AjayaDahal/TPMS-2018-Toyota-Yaris-iA/docs/premortem.md

# Premortem: how this TPMS panel could fail

**Date:** 2026-11-05, revised the same day.

**Scope:** everything, including the outline, which was accepted from the in-car paper fit on 2026-11-09.

## The setup

- **The car.** The Yaris iA's own TPMS is **indirect**: it compares ABS wheel speeds and has no sensors in the wheels. It keeps working on its own and never interacts with this panel.
- **The sensors.** You had four **GM/Schrader EG53MA4** sensors installed in the tyres, and this panel is their only receiver. Their protocol is known:
  - 315 MHz, OOK (on-off keying), Manchester coding, 123 µs half-bit;
  - a 120-bit message with ID, pressure, temperature and a checksum;
  - rtl_433 already decodes it as `Schrader-EG53MA4`.

> **Correction:** the first version of this premortem assumed factory Mazda sensors with an unknown protocol. That was wrong, and that risk doesn't exist.

The bring-up firmware now decodes these sensors directly. It lists each one's ID, pressure (kPa/psi), temperature and signal strength.
- The decoder follows rtl_433's slicer and frame checks.
- It's unit-tested with synthetic EG53MA4 transmissions: a valid frame, two repeats, a bad checksum and a truncated frame.
- It hasn't been tested against a real capture yet.

Imagine it's a year from now and the panel is sitting in a drawer. These are the most likely reasons, most likely first.

## Ranked failure stories

| # | How it fails | Likely? | Early warning | Mitigation | Status |
|---|---|---|---|---|---|
| 1 | OLED burn-in from a static screen | **High** (over months) | Ghost outlines | Firmware: dim or blank after ~30 s with no alarm, wake on knob or alarm, shift the layout a few pixels every few minutes | Firmware rule (below) |
| 2 | "It receives nothing" in the garage | **High** (early on) | Silence while parked | EG53MA4 sensors transmit when the wheel turns (about once a minute while driving) or when woken by the OEC-T5 tool. Parked, they stay quiet. Test by driving or with the tool | Documented; the bring-up firmware lists every sensor it hears |
| 3 | Readings from other cars, or the wrong wheel | Medium–High | Unknown IDs, values that jump, or swapped wheels after a tyre rotation | Learn the 4 IDs with the OEC-T5, one wheel at a time, and store them in NVS. Ignore all other IDs. Relearn after a rotation. Flag a wheel as stale if it hasn't been heard for 20 min while driving | Firmware rule; bring-up shows the IDs |
| 4 | Rear wheels drop out (weak signal) | Medium | Rear signal below about −95 dBm, or gaps | The E07 is tuned for 433 MHz (an estimated loss of up to ~10 dB). The FCC data still suggests 15–35 dB of margin. The radio now points its SMA down into the console pocket: use a 90° adapter with a 315 MHz antenna pointing straight back. If a rear wheel is weak, move the antenna out of the pocket on an extension cable, away from the steel floor tunnel. Check each wheel's signal strength with the bring-up firmware before the final install | Radio moved; measure |
| 5 | Board arrives and doesn't work, and it's unclear why | Medium | — | The self-test checks each part with a clear message. Power the bare board first and measure 5 V / 3V3 on the J4 pads before plugging in modules | Done |
| 6 | A module is plugged in rotated 180° (the CC1101's 2×4 header and the DevKit are symmetric) | Medium | Smoke | Before power, check the silkscreen: "1"/"SMA" on U1, "USB"/"ANTENNA" and pin names on A1, labels on J3 | Documented |
| 7 | Firmware never gets finished | Medium (lower now) | — | Reception and decoding are done in the bring-up firmware. Remaining work, in this order: learn mode → wheel layout UI → low-pressure alarm → burn-in protection → Wi-Fi/OTA (optional) | Plan |
| 8 | Vibration loosens the sockets | Medium | Random resets, blank display | Use machined round-pin gold sockets or solder the DevKit in. Add a dab of RTV on the modules. Put the antenna on an SMA extension. Crimp ferrules on the J1 wires | Documented |
| 9 | Heat in a parked car (70–90 °C) | Medium | Resets or a fading display in summer | The OLED, ESP32 and CC1101 are rated to 85 °C, so mount the panel out of direct sun. U4 has a copper heatsink pour. Avoid full-white screens (or use display jumper option #1 with JP1) | Pour done; mounting is your call |
| 10 | Random resets on the bench | Medium | Resets when the screen is bright or Wi-Fi is on | A laptop port (500 mA) can't supply the OLED's ~375 mA plus Wi-Fi peaks. Use a 12 V supply or a powered hub | Documented |
| 11 | One sensor goes quiet | Low–Medium (over years) | One wheel stops updating | Sensor battery life is typically 5–10 years, or a sensor may be in its off/storage mode. Show "stale" for that wheel and wake it with the OEC-T5 | Firmware rule |
| 12 | Garbled display or failed radio set-up from the shared SPI bus | Low | Random characters, a wrong CC1101 VERSION | The firmware uses 4 MHz SPI, transactions, and weaker SCK/MOSI drive for the ~100–130 mm tracks. The CC1101 releases MISO when it isn't selected | Done |
| 13 | Interrupt flood at boot from GDO0's 135 kHz default clock | Low | Watchdog resets | Configure the CC1101 before attaching the IO34 interrupt | Done in the firmware |
| 14 | Car battery drained | Low (if wired right) | Dead battery after a few days parked | ACC only, never constant 12 V. The panel draws ~1 W, which flattens a battery in about two weeks. Fuse the tap | Documented |
| 15 | AM radio buzz from the 5 V switcher | Low | Noise on AM | Add TRACO's EMC input filter to the 12 V lead | Documented |
| 16 | Front USB sockets don't charge or connect | Low | Phone doesn't charge from a front port | They are passive USB passthrough cables, not wired to the board (U3 can't power phones). One plugs into the car's USB port, the other into a 12 V USB charger in the 12 V socket | Plan set |
| 17 | A substitute part doesn't fit | Low | — | Avoid: R-78E (28 V max), a passive buzzer, blue/white LEDs on 220 Ω, a WROVER or 38-pin DevKit | Documented |
| 18 | Doesn't fit the console opening once built | Low–Medium | Board doesn't sit flush | The template matched the opening under the HVAC controls, and a caliper span agrees. The board is 1 mm smaller than the opening on the sides and bottom so it can't be too big. Gaps are closed by a 3D-printed bezel/chassis, which can also space the board forward if the 12 V/USB/AUX strip behind it is in the way | Outline accepted; chassis later |
| 19 | The shift knob (in P) hits a cable in the right USB socket | Medium | Cable touches the knob in P | Measure the gap; use a 90° USB cable, or move that socket up and left | Check |
| 20 | Losing the car's 12 V socket / USB / AUX behind the panel, or the plugs keep the panel from sitting flush | Medium | Panel stands off at the top | Two USB passthroughs bring the car's USB and a 12 V charger to the front. The car's ports face the panel, so use 90° USB-A adapters and a flush 12 V charger, and leave slack. The 8 mm side slot is free for an extra cable. The 3D-printed chassis can space the panel forward if needed | Plan set; check depth |
| 21 | The passthrough sockets don't fit the holes, or their nut hits a part | Low | Thread won't go through, or the nut doesn't sit flat | The thread was measured at 25.16 mm (M25 class), so the holes are Ø25.8 mm. The Ø38 mm parts-free circle on both sides fits a typical M25 nut (35–37 mm across corners); the nearest part (U3) is at 19.8 mm. DRC-enforced. Ease with a round file if a thread binds | Holes resized |
| 22 | USB cables add noise at 315 MHz | Low | Noise floor rises when a phone is connected/charging | Route the cables away from the antenna; clip-on ferrites near the plugs; compare the bring-up firmware's noise floor with and without a phone | Check at bring-up |

## Firmware rules that prevent several of these

- Configure the CC1101 before enabling the GDO0 interrupt. Never put the CC1101 in transmit mode.
- Only accept the 4 learned IDs. Store them in NVS when they change; ACC can cut power at any moment.
- Show "no data" or "stale" per wheel instead of an old value.
- Protect the OLED: dim or blank it when idle, and shift the layout periodically.
- Keep alarms audible (buzzer) and glanceable (wheel LEDs), so you don't need to read the screen while driving.

## Next steps, in order

1. **Optional quick check now:** run `rtl_433 -f 315M` on your RTL-SDR while driving. It should print `Schrader-EG53MA4` lines for all four tyres. Note their IDs, and wake each wheel with the OEC-T5 to see which ID belongs to which wheel.
2. Order the PCB (`tpms_panel_gerbers_jlcpcb.zip`). The USB holes already match the measured thread.
3. Assemble and run the bring-up firmware: self-test, then the sensor list with signal strength per wheel.
4. Build learn mode, the wheel layout, alarms and burn-in protection.
5. Install: fused ACC tap, antenna placement, vibration-proofing.
