AjayaDahal/TPMS-2018-Toyota-Yaris-iA/TPMS_project_report_ECE6723.pdf

# ECE 6723 Embedded System

# Spring 2022

# Grad Project - TPMS Monitoring System

# Student: Ajaya Dahal

# Department of Electrical and Computer Engineering Bagley College of Engineering Mississippi State University

# Date: May 10, 2022

## 1. Introduction

For a long time, I wanted to design a 315MHz receiver from scratch using analog components. The motivation came from my car. I have a car with tire pressure monitoring system sensors on all tires. However, the infotainment system is not as advanced that would tell me which tire is low on tire pressure and by how much. All it could do is turn on the tire pressure sign on the dashboard. After reading [5], I was able to find out about the TPMS sensors. In the United States, a 315MHz (https://tpms247.com/blogs/tpms-faq/73376901-tpms-frequencies-315-mhz-433mhz) transmitter
[6] is used by the TPMS sensors. The initial idea was to design a PCB that uses analog components that will be able to receive at 315MHz. But after looking into rf circuit design, it was easier to simply use a 315MHz receiver (https://www.amazon.com/HiLetgo-Transmitter-Receiver-Arduino-Raspberry/dp/B00LNADJS6) as shown in figure 1.1 to accomplish this.

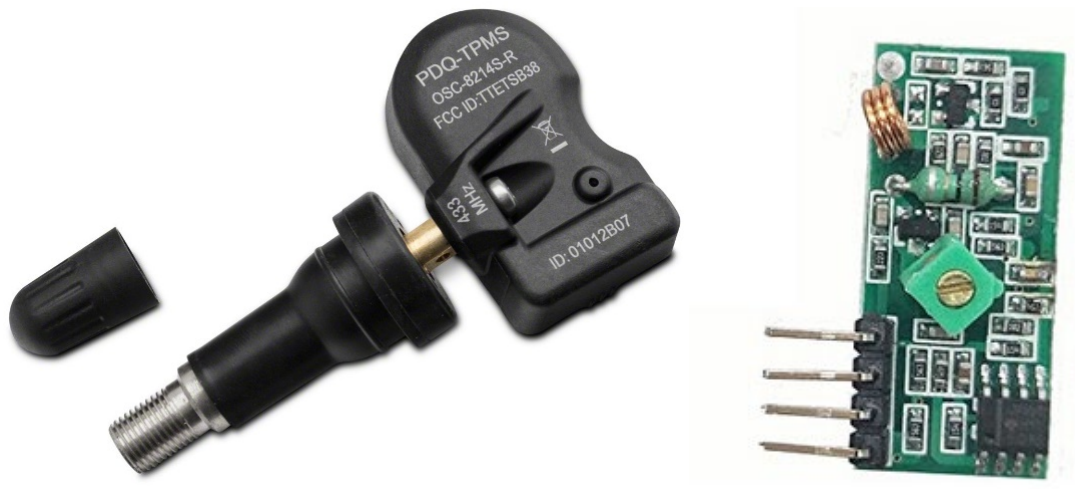
[picture p3: figure]

Figure 1.1: TPMS sensors on the left and 315MHz receiver on the right.

## 2. Literature review

There has been some similar work in this field. The engineer from [1] used the Seeduino Xiao microcontroller and TI CC1101 Module to create a device with a 1.8 in TFT SPI display. The engineer has done a lot of work and has a big contribution to the various model of cars. Similarly, the author from [2] was able to provide a huge insight into how this TPMS sensor works. Although this method is to create the TPMS sensor, it helped to understand the thought process while designing one of these sensors. Using the FCC ID of the sensors, I was able to retrieve the datasheet [3] of the device. Figure 2.1 is the screenshot from the datasheet showing

## the brief information about the sensor:

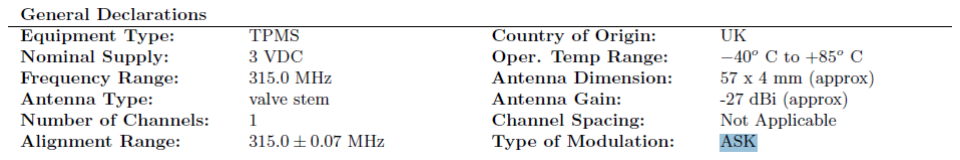
[picture p4: figure]

## Figure 2.1 General Overview of the Sensor

Reading the datasheet provided lots of technical details about the sensor. After reading the

## datasheet it was clear that the sensors transmit at center frequency 315 MHz with ASK modulation with the emission bandwidth of 0.0550MHz at 20 dB EBW max at 0.7875 MHz. The

sensor has 7 modes of operation.

## These modes are shown in table 2.1 below:

## Table 2.1: Different modes of operation of the sensor

Emergency Modes | Consumer Use Modes | Manufacturing & Service Modes | Mode of Operation | Explanation | Frequency of Transmission
| | X Forced | Transmission "Learn Mode" (dealer / plant) | On receipt of a particular LF sequence this Forced transmission allows the interrogation of the sensor in the vehicle factory or dealership | Forced Transmission as required
| | X | Low battery | Transmitter in normal operation when a low battery flag has been set - wheel is rotating | Transmission rate depending on Drive mode
| | X | Off Mode | Part is in an off state, No transmissions, Exit by LF orΔP | No transmissions
| X Stationary | | Mode
| X Wake Mode | | Fartory Drive Mode | First transmittion in normal operation - when wheel is rotating then moves into drive mode | At the start of wheel rotation
| X | | | Transmitter in normal operation - wheel is rotating | Transmission rate every 30secs
| X | | Drive Mode | Transmitter in normal operation - wheel is rotating | Transmission rate every 60secs
X Pressure Re- | | | Measure Mode | Transmitter in normal operation and meassuresment sample which is less then 5 counts than the pervious sample | Alarm transmission as required

As shown in the table above, the device has seven modes of operation.

## 3. Methods

The receiver is compatible with any microcontroller and the engineers who designed this has also built a library. Figure 3.1 shows the schematics of the receiver that can be considered in the future when designing a PCB with all components on a single board.

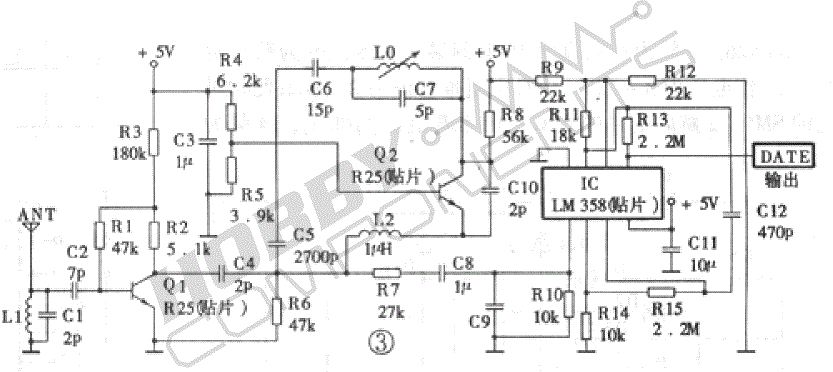
[picture p5: figure]

## Figure 3.1: Schematics of the MX-05 (HCMODU0007) receiver module. [8]

After learning about the receiver, sensor, and its different modes of operation, the project then moved to learn about ASK modulation.
As per the source [4], “With Manchester encoding, bit transitions near the mid-point of bit periods determine the polarity of the transmitted and/or received bit. A rising transition/edge in the middle of a bit period typically corresponds to a logic “0” while a falling transition during the middle of a bit period corresponds to logic “1” as shown in the demodulated waveform timing diagram of Figure [3.]1. Transitions at or near bit boundaries are ignored”.

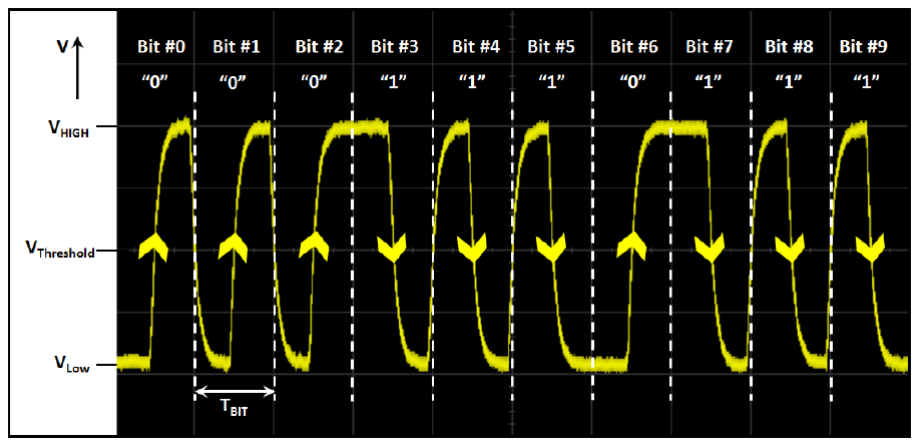
[picture p6: figure]

Figure 3.2: Bit polarities based on Manchester encoding.

## Further reading PowerPoint from LinkedIn [7] helped to understand ASK modulation and

demodulation, Figure 3.3 shows how the signal is demodulated.

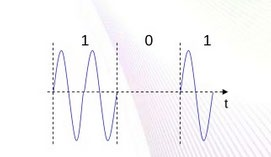
[picture p7: figure]

## Figure 3.3: ASK signal for demodulating

Further reading the datasheet [3], I was able to find the pulsed emission characteristics for the sensor.

The table 3.1 below shows the pulsed emission characteristics for the device.

## Table 3.1: Pulsed Emission Characteristics (Duty Cycle). [3]

FCC/IC

EUT Test
Mode*
Overall Transmission | Internal Frame Characteristics | Computed
Duty Cycle
Min.
Repetition
Rate (sec)

Max.
No. of
Frames

Total
Transmission
Length (sec)

Max.
Frame
Length
(ms)

Min.
Frame
Period
(ms) | Frame Encoding | (%) | (dB)
1 | Worst-case ORIG Learn Mode. See Figure (b) | Single | 16 | < 5 | 27.6750 | >100 | When manually actuated by encoded LF, the EUT transmits 16 frames of ASK data. Each ASK frame is 27.675 ms in length, composed of Manchester encoded data with 124.8 us / 239.2 us duty. | 14.4 | -16.8
2 | Worst-case ORIG Roll Mode. See Figure (a) | 60.0 | 6 | < 1 | 27.6750 | >100 | Same as above. | 14.4 | -16.8
3 | Worst-case ADDED Learn Mode. See Figure (b) | Single | 32 | < 5 | 13.3500 | >100 | When manually actuated by encoded LF, the EUT transmits 32 frames of ASK data. Each ASK frame is 13.35 ms in length, containing one 486.4 us pulse, 13 123.2 us timing pulses, one 499.2 us pulse, and 8.8464 ms of Manchester encoded data with 123.2 us / 243.6 us duty. | 7.1 | -20.0
4 | Worst-case ADDED Rolling Mode. See Figure (c) | 60 | 8 | < 1 | 13.3500 | >100 | Same as above. | 7.1 | -20.0

As shown in Table 3.1, the device when operated in learn mode can transmit 16 frames of ASK

## data in Manchester encoded form. With the newer model, the new learn mode can send 32

frames of ASK data providing a longer time while performing experiments. For the sensor to operate in learn mode, the sensor requires to be manually actuated by using the encoded LF learn tool. So, a learning tool was purchased from [9] which is shown in figure 3.4.

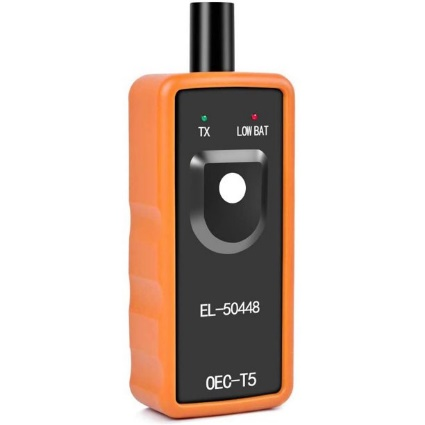
[picture p8: figure]

## Figure 3.4: LF relearn tool. [9]

To verify that the sensor is transmitting while using LF learn tool, an RTL-SDR was used as a

## spectrum analyzer using GNURadio as shown in figure 3.5 below:

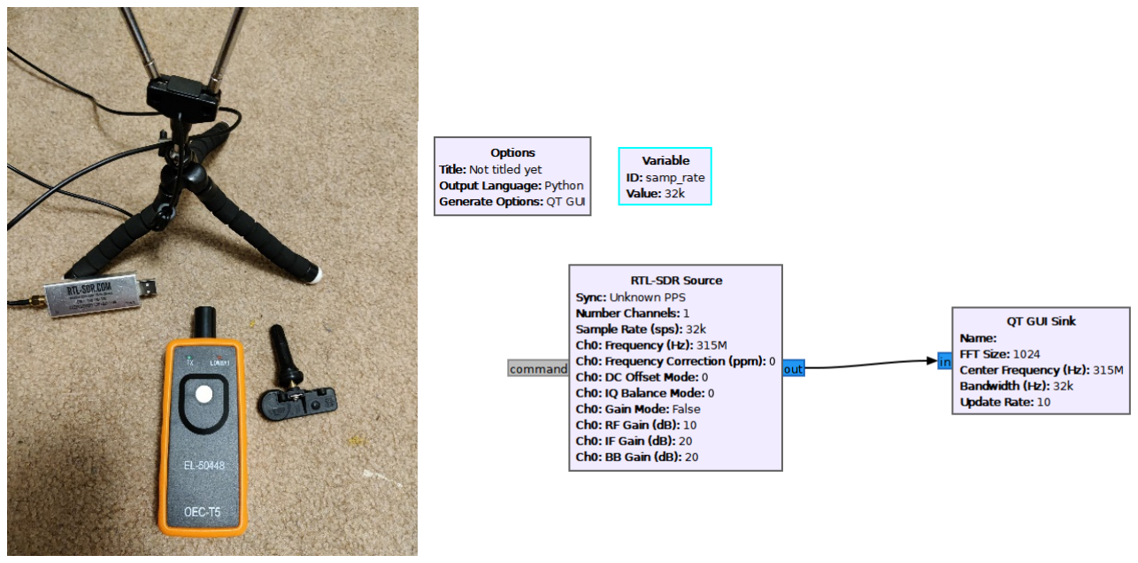
[picture p9: figure]

Figure 3.5: Experiment setup.

In progress: Reading the codes from [10] and [11] and trying to conduct some experiments with the receiver to start decoding and showing in the display. PCB layout has been completed and is

## shown in Figure 3.6 below:

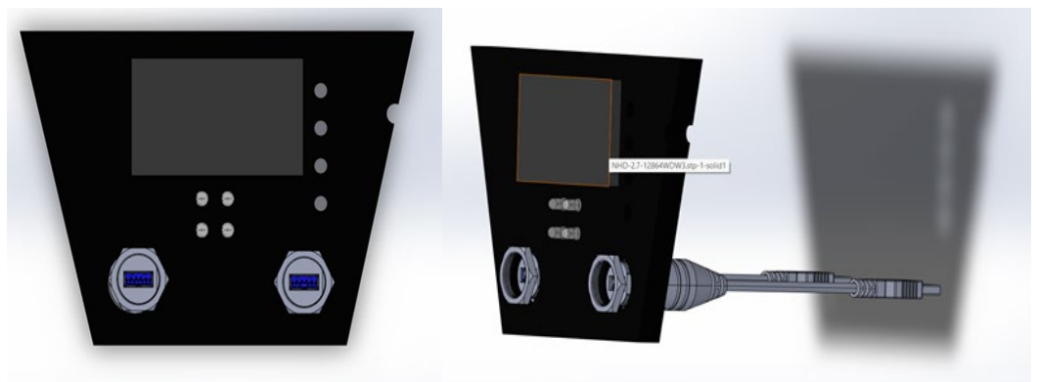
[picture p10: figure]

Figure 3.6: PCB and hardware UI layout.

## 4. Conclusion

So far, I have learned about TPMS sensors, and ASK modulation and in the future, I hope to actually be able to decode the signal and show it in the display as I have planned. This project not only helped me to learn embedded system general electronics circuit design but also made me more curious about different modulation and demodulation schemes there are in the world of RF and communications.

## 5. References

[1] “Arduino TPMS Tyre Pressure Display,” Hackster.io.

# https://www.hackster.io/jsmsolns/arduino-tpms-tyre-pressure-display-b6e544 (accessed

May 11, 2022).
[2] SilegoMore, “Tire Pressure Sensor,” Instructables. https://www.instructables.com/Tire-Pressure-Sensor/ (accessed May 11, 2022).
[3] “Federal Communications Commission,” Federal Communications Commission,

# 2018. http://FCC.gov

[4] Google.com, 2022.

# https://www.google.com/url?sa=t&rct=j&q=&esrc=s&source=web&cd=&ved=2ahUKE wiOpZPuotb3AhXxg2oFHbF9D2EQFnoECAMQAQ&url=https%3A%2F%2Ftekmarkgr oup.com%2Feshop%2Fimage%2Fcatalog%2F4000series%2FMSOX4052A%2F3.AutoK eyFobCommunication-an.pdf&usg=AOvVaw1IGKDzc9WiR39xVa52g_qE (accessed

May 11, 2022).

# [5] “How do I Know if my Vehicle is Equipped with TPMS? | Schrader TPMS Solutions,” www.schradertpms.com. https://www.schradertpms.com/en/driver-

education/how-do-i-know-if-my-vehicle-equipped-tpms (accessed May 11, 2022).
[6] “TPMS Frequencies - 315 MHz vs. 433MHz - Which Do I Need?,” TPMS 24/7.

# https://tpms247.com/blogs/tpms-faq/73376901-tpms-frequencies-315-mhz-433mhz

(accessed May 11, 2022).
[7] “See Roshni Prasad’s activity on LinkedIn,” www.linkedin.com.

# https://www.linkedin.com/feed/update/urn:li:activity:6921301585620832256/ (accessed

May 11, 2022).

# [8] “433MHz Wireless Modules MX-FS-03V & MX-05 (HCMODU0007) -

forum.hobbycomponents.com,” forum.hobbycomponents.com. https://forum.hobbycomponents.com/viewtopic.php?t=1324 (accessed May 11, 2022).

# [9] “TPMS sensor,” www.walmart.com. https://www.walmart.com/ip/TekDeals-EL-50448-Auto-Tire-Pressure-Monitor-Sensor-TPMS-Relearn-Reset-Activation-Tool-OEC-

T5-for-GM-Series-Vehicle/917256454 (accessed May 11, 2022).

# [10] J. Boone, “TPMS,” GitHub, Apr. 18, 2022. https://github.com/jboone/tpms

(accessed May 11, 2022).

# [11] B. Larsson, “rtl_433,” GitHub, May 10, 2022. https://github.com/merbanan/rtl_433

(accessed May 11, 2022).

Date of Issue: September 15, 2013 | Prepared For: Schrader Electronics | Test Report No.: 20130915-01

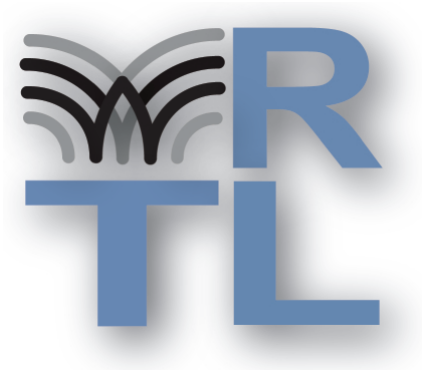
[picture p11: figure]

Willow Run Test Labs, LLC
8501 Beck Road, Building 2227 Belleville, Michigan 48111 USA Tel: (734) 252-9785
Fax: (734) 926-9785
e-mail: info@wrtest.com

Testing of

# Electromagnetic Emissions

per

USA: CFR Title 47, Part 15.231(e) Canada: IC RSS-210/GENe

are herein reported for

# Schrader Electronics EG53MA4

Test Report No.: 20130915-01 Copyright

c 2013

Applicant/Provider:
Schrader Electronics
11 Technology Park, Belfast Road, Antrim Northern Ireland BT41 1QS United Kingdom Phone: +44 28 9448 3067, Fax: +44 28 9446 8440

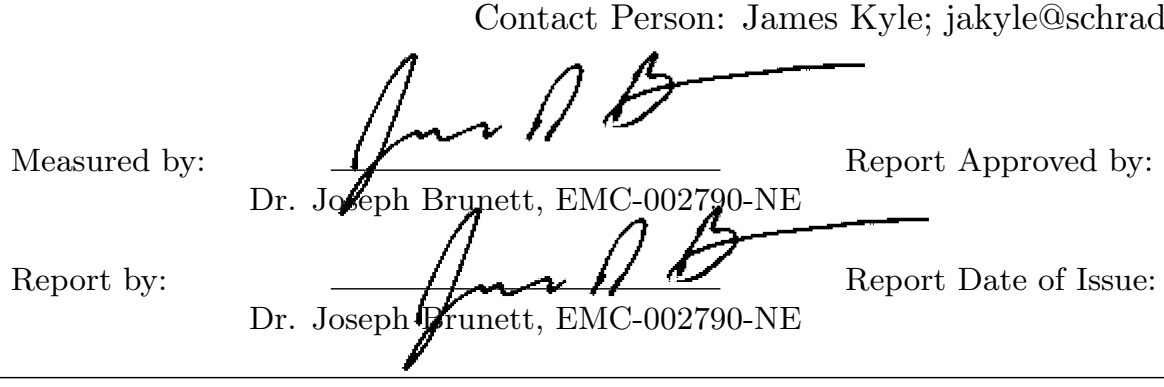
[picture p12: figure]
Measured by:; Report Approved by:; Dr. Joseph Brunett, EMC-002790-NE

Contact Person: James Kyle; jakyle@schrader.co.uk

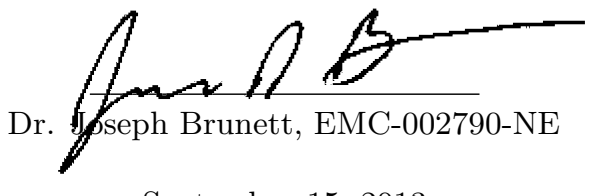
[picture p13: figure]

Dr. Joseph Brunett, EMC-002790-NE | Dr. Joseph Brunett, EMC-002790-NE
Report by: | Report Date of Issue: | September 15, 2013

Results of testing completed on (or before) September 15, 2013 are as follows.

Emissions: The transmitter fundamental emission meets the regulatory limit(s) by no less than 6.1 dB. Transmit chain spurious harmonic emissions comply by no less than 3.1 dB.

Willow Run Test Labs, LLC, 8501 Beck Road, Building 2227, Belleville, Michigan 48111 USA | Page 1 of 17

## 6. Appendix

Date of Issue: September 15, 2013 | Prepared For: Schrader Electronics | Test Report No.: 20130915-01

Contents

1 Test Specifications, General Procedures, and Location | 3
1.1 Test Specification and General Procedures | | 3
1.2 Test Location and Equipment Used | | 4
2 Configuration and Identification of the Equipment Under Test | 5
2.1 Description and Declarations | | 5
2.1.1 | EUT Configuration | | 5
2.1.2 | Modes of Operation | | 5
2.1.3 | Variants | | 6
2.1.4 | Test Samples | | 6
2.1.5 | Functional Exerciser | | 6
2.1.6 | Modifications Made | | 6
2.1.7 | Production Intent | | 6
2.1.8 | Declared Exemptions and Additional Product Notes | | 6
3 Emissions | 7
3.1 General Test Procedures | | 7
3.1.1 | Radiated Test Setup and Procedures | | 7
3.1.2 | Conducted Emissions Test Setup and Procedures | | 9
3.1.3 | Power Supply Variation | | 9
3.1.4 | Thermal Variation | | 9
3.2 Intentional Emissions | 10
3.2.1 | Fundamental Emission Pulsed Operation | 10
3.2.2 | Fundamental Emission Bandwidth | 15
3.2.3 | Fundamental Emission | 16
3.3 Unintentional Emissions | 17
3.3.1 Transmit Chain Spurious Emissions | 17

List of Tables

1 | Willow Run Test Labs, LLC Equipment List | | 4
2 | EUT Declarations | | 5
3 | Pulsed Emission Characteristics (Duty Cycle) | 10
4 | Intentional Emission Bandwidth. | | 15
5 | Fundamental Radiated Emissions | 16
6 | Transmit Chain Spurious Emissions | 17

List of Figures

1 | Photos of EUT. | | | 5
2 | EUT Test Configuration Diagram | | 6
3 | Radiated Emissions Diagram of the EUT | | 7
4 | Radiated Emissions Test Setup Photograph(s) | | 8
5 | Pulsed Emission Characteristics (Duty Cycle) | 11
5 | Pulsed Emission Characteristics (Duty Cycle) | 12
5 | Pulsed Emission Characteristics (Duty Cycle) | 13
5 | Pulsed Emission Characteristics (Duty Cycle) | 14
6 | Intentional Emission Bandwidth. | | 15
Willow Run Test Labs, LLC, 8501 Beck Road, Building 2227, Belleville, Michigan 48111 USA | Page 2 of 17

### 1 Test Specifications, General Procedures, and Location

### 1.1 Test Specification and General Procedures

The ultimate goal of Schrader Electronics is to demonstrate that the Equipment Under Test (EUT) complies with the Rules and/or Directives below. Detailed in this report are the results of testing the Schrader Electronics EG53MA4 for compliance to:

Country/Region | Rules or Directive | Referenced Section(s)
United States | Code of Federal Regulations | CFR Title 47, Part 15.231(e)
Canada | Industry Canada | IC RSS-210/GENe

In association with the rules and directives outlined above, the following specifications and procedures are followed herein.

ANSI C63.4-2003 | ”Methods of Measurement of Radio-Noise Emissions from Low-Voltage Electri-
cal and Electronic Equipment in the Range of 9 kHz to 40 GHz”
Industry Canada | ”The Measurement of Occupied Bandwidth”
Willow Run Test Labs, LLC, 8501 Beck Road, Building 2227, Belleville, Michigan 48111 USA | Page 3 of 17

### 1.2 Test Location and Equipment Used

Test Location The EUT was fully tested by Willow Run Test Labs, LLC, 8501 Beck Road, Building 2227, Belleville, Michigan 48111 USA. The Test Facility description and attenuation characteristics are on file with the FCC Laboratory, Columbia, Maryland (FCC Reg. No: 688478) and with Industry Canada, Ottawa, ON (File Ref. No: IC 8719A-1).

Test Equipment Pertinent test equipment used for measurements at this facility is listed in Table 1. The quality system employed at Willow Run Test Labs, LLC has been established to ensure all equipment has a clearly identifiable classification, calibration expiry date, and that all calibrations are traceable to the SI through NIST, other recognized national laboratories, accepted fundamental or natural physical constants, ratio type of calibration, or by comparison to consensus standards.

Table 1: Willow Run Test Labs, LLC Equipment List.

Description | Manufacturer/Model | SN | Quality Number | Last Cal By / Date Due
Antennas
Shielded Loop (9 kHz - 50 MHz) | EMCO/6502 | 2855 | UMLOOP1 | UMRL / July-2014
Dipole Set (20 MHz - 1000 MHz) | EMCO/3121C | 9504-1121 | DIPEMC001 | Liberty Labs / Sept-2013
| JEF | 1 | BICJEF001 | UMRL / July-2014
| JEF | 1 | SBICJEF001 | UMRL / July-2014
Log-Periodic Array (200 MHz - 1000 MHz) | | 1 | LOGJEF001 | UMRL / July-2014
Ridge-Horn Antenna | Univ. of Michigan | 5 | UMHORN005 | UMRL / July-2014
L-Band | JEF | | HRNL001 | JEF / July-2014*
LS-Band Horns | JEF/NRL | 001, 002 | HRN15001, HRN15002 | JEF / July-2014*
S-Band Horns | Scientific-Atlanta | 1854 | HRNSB001 | JEF / July-2014*
C-Band | JEF/NRL | 1 | HRNC001 | JEF / July-2014*
| JEF/NRL | 001, 002 | HRNXN001, HRNXN002 | JEF / July-2014*
X-Band Horns | JEF/NRL | 001, 002 | HRNXB001, HRNXB002 | JEF / July-2014*
| JEF/NRL | 001, 002 | HRNKU001, HRNKU002 | JEF / July-2014*
| JEF/NRL | 001, 002 | HRNKA001, HRNKA002 | JEF / July-2014*
Quad-Ridge Horns | Condor AS-48461 | C35200 | QRH218001 | WRTL / July-2014
Receiver’s / Spectrum Analyzers
Spectrum Analyzer | HP/8593E | 3649A02722 | HP8593E001 | DTI / Nov-2013
Signal Generators
Tracking Generator | HP/8593E | 3649A02722 | HP8593E001 | DTI / Nov-2013
Line Impedance Stabilization Networks
LISN | EMCO | 9304-2081 | LISNEM001 | JEF / Jan-2014

* Verification Only - Standard Gain Horn Antennas

Bicone (20 MHz - 250 MHz)
Bicone (200 MHz - 1000 MHz) JEF/Isbell

XN-Band Horns

Ku-Band Horns
Ka-Band Horns
Willow Run Test Labs, LLC, 8501 Beck Road, Building 2227, Belleville, Michigan 48111 USA | Page 4 of 17

### 2 Configuration and Identification of the Equipment Under Test

### 2.1 Description and Declarations

The EUT is a wireless tire pressure and temperature sensor. The EUT is approximately 5.5 x 7.2 x 0.9 cm (with stem) in dimension, and is depicted in Figure 1. It is powered by a 3 VDC Lithium cell battery. In use, this device is permanently affixed as the valve-stem in the tire of a motor vehicle. Table 2 outlines provider declared EUT specifications.

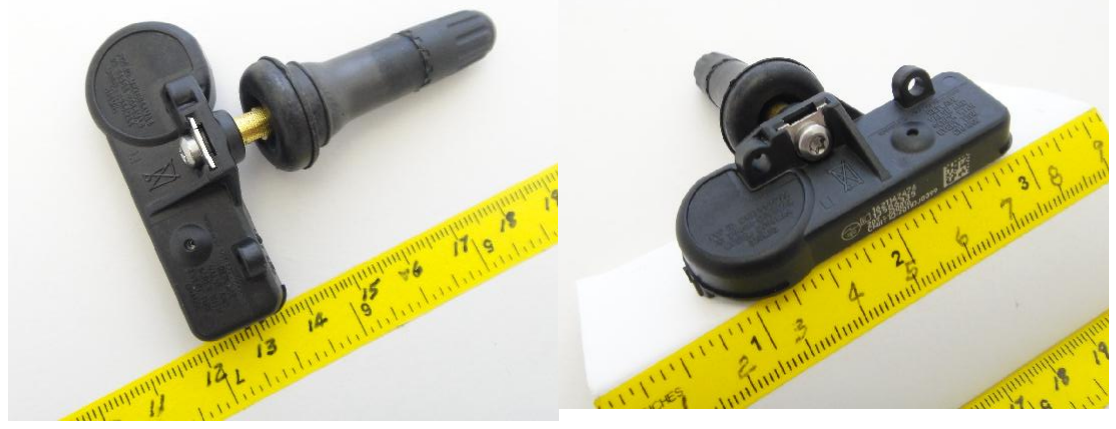
[picture p14: figure]

Figure 1: Photos of EUT.

Table 2: EUT Declarations.

General Declarations
Equipment Type: | TPMS | Country of Origin: | UK
Nominal Supply: | 3 VDC | Oper. Temp Range: | −40o C to +85o C
Frequency Range: | 315.0 MHz | Antenna Dimension: | 57 x 4 mm (approx)
Antenna Type: | valve stem | Antenna Gain: | -27 dBi (approx)
Number of Channels: | 1 | Channel Spacing: | Not Applicable
Alignment Range: | 315.0 ± 0.07 MHz | Type of Modulation: | ASK

United States
FCC ID Number: | MRXEG53MA4 | Classification: | DSC

Canada
IC Number: | 2546A-EG53MA4 | Classification: | Remote Control Device, Ve-
| | | hicular Device

### 2.1.1 EUT Configuration

The EUT is configured for testing as depicted in Figure 2.

### 2.1.2 Modes of Operation

The EUT is capable of three key modes of operation. Upon manually activated LF interrogation (through the use of special LF tool at a vehicle dealership), the EUT responds with a single transmission containing a number of frames

Willow Run Test Labs, LLC, 8501 Beck Road, Building 2227, Belleville, Michigan 48111 USA | Page 5 of 17

## EUT

## Schrader Electronics TPMS Transmitter Type Designator: EG53MA4

Figure 2: EUT Test Configuration Diagram.

used to configure the device with the vehicle . When the EUT is placed in the vehicle tire and the vehicle drives, it can, in the worst case, periodically transmit where the duration of each transmission is always less than 1 second and the silent period between transmissions is at least 30 times the duration of the transmission, and never less than 10 seconds. Depending on encoded LF employed to setup the device, it may respond with either the ORIGINAL or ADDED encodings detailed in this report. In the case of an emergency condition, the EUT will transmit tire pressure and temperature information throughout the duration of the condition.

### 2.1.3 Variants

There is only a single variant of the EUT. Normal samples were provided programmed into worst case on time, worst case emission bandwidth, and CW mode using a supplied LF tool.

### 2.1.4 Test Samples

Three samples in total were provided. Two normal samples capable of normal, test, and CW mode activation (one (sample number 70503396) was fixed to transmit only the ORIGINAL certified encoding, and one (sample number 70503693) was fixed to transmit only the new ADDED encoding). Finally, a third sample was provided un-potted for testing and photographs.

### 2.1.5 Functional Exerciser

Normal operating EUT functionality was verified by observation of transmitted signal from EUT after LF activation.

### 2.1.6 Modifications Made

There were no modifications made to the EUT by this laboratory.

### 2.1.7 Production Intent

The EUT appears to be a production ready sample.

### 2.1.8 Declared Exemptions and Additional Product Notes

The EUT is permanently installed in a transportation vehicle. As such, digital emissions are exempt from US and Canadian digital emissions regulations (per FCC 15.103(a) and IC correspondence on ICES-003).
The EUT also employs some modes of operation that alert the vehicle user of sudden changes in tire pressure. Such alert modes fall under FCC 15.231(a)(4), and may operate during the pendency of the alarm condition. A detailed list of all operating modes is included in the Description of Operation exhibit included in this application.
Willow Run Test Labs, LLC, 8501 Beck Road, Building 2227, Belleville, Michigan 48111 USA | Page 6 of 17

### 3 Emissions

### 3.1 General Test Procedures

### 3.1.1 Radiated Test Setup and Procedures

Radiated electromagnetic emissions from the EUT are first evaluated in our shielded fully anechoic chamber. Spectrum and modulation characteristics of all emissions are recorded, and emissions above 1 GHz are fully characterized. The anechoic chamber contains a set-up similar to that of our outdoor 3-meter site, with a turntable and antenna mast. Instrumentation, including spectrum analyzers and other test equipment as detailed in Section 1.2 are employed. After indoor pre-scans, emission measurements are made on our outdoor 3-meter Open Area Test Site (OATS). If the EUT connects to auxiliary equipment and is table or floor standing, the configurations prescribed in ANSI C63.4 / CISPR-22 are followed. Alternatively, a layout closest to normal use (as declared by the provider)
is employed if the resulting emissions appear to be worst-case in such a configuration. See Figure 3. | All

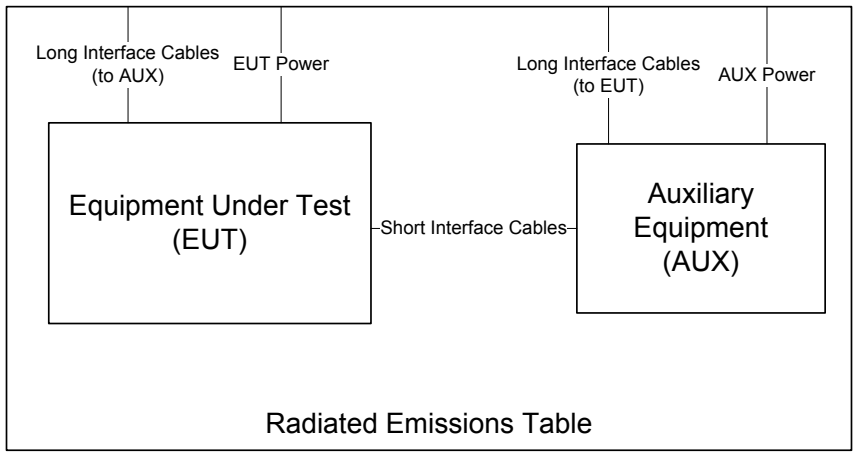
[picture p15: figure]
Radiated Emissions Table; Equipment Under Test (EUT); Auxiliary Equipment (AUX); Long Interface Cables; (to AUX); EUT Power; AUX Power; Short Interface Cables; Long Interface Cables (to EUT)

Figure 3: Radiated Emissions Diagram of the EUT.

intentionally radiating elements are placed on the test table lying flat, on their side, and on their end (3-axes) and the resulting worst case emissions are recorded. For both horizontal and vertical polarizations, the test antenna is raised and lowered from 1 to 4 m in height until a maximum emission level is detected. The EUT is then rotated through 360o
in azimuth until the highest emission is detected. The test antenna is then raised and lowered one last time from 1 to 4 m and the worst case value is recorded. Photographs of the test setup employed are depicted in Figure 4.
If the EUT exhibits spurious emissions due to internal receiver circuitry, such emissions are measured with an appropriate carrier signal applied. For devices with intentional emissions below 30 MHz, a shielded loop antenna is used as the test antenna. It is placed at a 1 meter receive height and appropriate low frequency magnetic field extrapolation to the regulatory limit distance is employed. Emissions between 30 MHz and 1 GHz are measured using tuned dipoles and/or calibrated broadband antennas. Emissions above 1 GHz are characterized using standard gain horn antennas or calibrated broadband ridge-horn antennas. Care is taken to ensure that test receiver resolution and video bandwidths meet the regulatory requirements, and that the emission bandwidth of the EUT is not reduced. Where regulations allow for direct measurement of field strength, power values (dBm) measured on the test receiver / analyzer are converted to dBµV/m at the regulatory distance, using

Edist = 107 + PR + KA − KG + KE − CF

where PR is the power recorded on spectrum analyzer, in dBm, KA is the test antenna factor in dB/m, KG is the combined pre-amplifier gain and cable loss in dB, KE is duty correction factor (when applicable) in dB, and CF is a distance conversion (employed only if limits are specified at alternate distance) in dB. This field strength value is then compared with the regulatory limit. If effective isotropic radiated power (EIRP) is compute, it is computed as

EIRP(dBm) = E3m(dBµV /m) − 95.2.

Willow Run Test Labs, LLC, 8501 Beck Road, Building 2227, Belleville, Michigan 48111 USA | Page 7 of 17

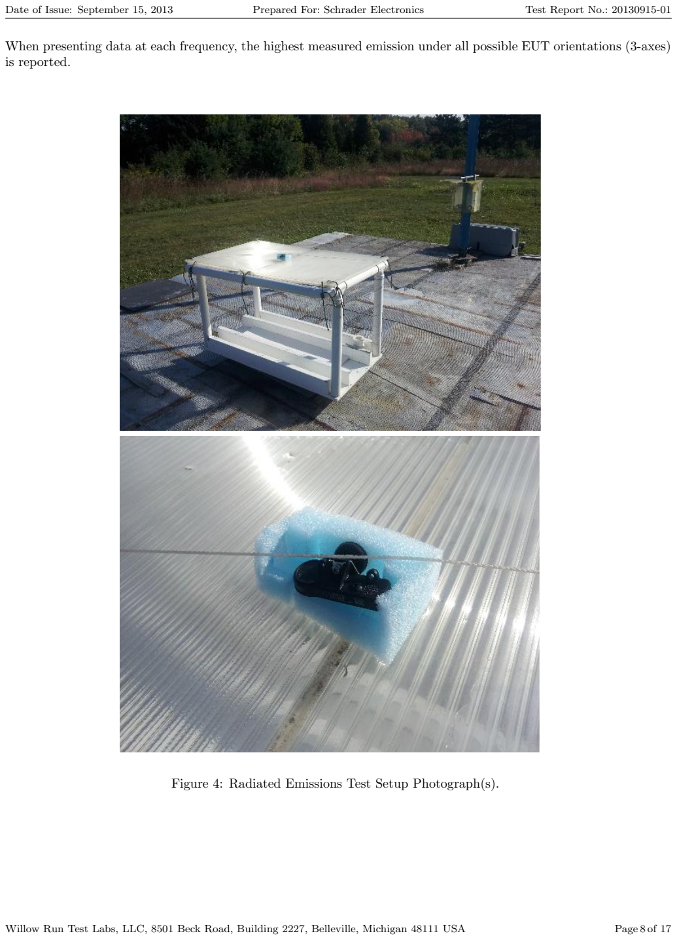
[picture p16: page 15]

When presenting data at each frequency, the highest measured emission under all possible EUT orientations (3-axes) is reported.

Figure 4: Radiated Emissions Test Setup Photograph(s).

Willow Run Test Labs, LLC, 8501 Beck Road, Building 2227, Belleville, Michigan 48111 USA | Page 8 of 17

### 3.1.2 Conducted Emissions Test Setup and Procedures

Battery Power Conducted Spurious The EUT is not subject to measurement of power line conducted emissions as it is powered solely by its internal battery.

### 3.1.3 Power Supply Variation

Tests at extreme supply voltages are made if required by the the procedures specified in the test standard, and results of this testing are detailed in this report.
In the case the EUT is designed for operation from a lead-acid battery power source, the extreme test voltages are evaluated between 90% and 130% of the nominal battery voltage declared by the manufacturer. For float charge applications using gel-cell type batteries, extreme test voltages are evaluated between 85% and 115% of the nominal battery voltage declared. For all battery operated equipment, worst case intentional and spurious emissions are re-checked employing a new (fully charged) battery.

### 3.1.4 Thermal Variation

Tests at extreme temperatures are made if required by the procedures specified in the test standard, and results of this testing are detailed in this report. The provider has declared that the EUT is designed for operation over the temperature range −40o C to +85o C. Before any temperature measurements are made, the equipment is allowed to reach a thermal balance in the test chamber, temperature and humidity are recorded, and thermal balance is verified via a thermocouple based probe.

Willow Run Test Labs, LLC, 8501 Beck Road, Building 2227, Belleville, Michigan 48111 USA | Page 9 of 17

### 3.2 Intentional Emissions

### 3.2.1 Fundamental Emission Pulsed Operation

The details and results of testing the EUT for pulsed operation are summarized in Table 3. Plots showing the measurements made to obtain these values are provided in Figure 5.

Table 3: Pulsed Emission Characteristics (Duty Cycle).

| | | Test Date: | 16-Sep-13
Detector | IF Bandwidth | Video Bandwidth | Test Engineer: Joseph Brunett
Pk | 1 MHz | 3 MHz | Meas Distance: | 10 cm
| | | | FCC/IC
# | EUT Test Mode* | Overall Transmission | | | | Internal Frame Characteristics | | Computed Duty

1 | Worst-case ORIG Learn Mode. See Figure (b) | Single | 16 | < 5 | 27.6750 | >100 | When manually actuated by encoded LF, the EUT transmits 16 frames of ASK data. Each ASK frame is 27.675 ms in length, composed of Manchester encoded data with 124.8 us / 239.2 us duty. | 14.4 | -16.8
2 | Worst-case ORIG Roll Mode. See Figure (a) | 60.0 | 6 | < 1 | 27.6750 | >100 | Same as above. | 14.4 | -16.8
3 | Worst-case ADDED Learn Mode. See Figure (b) | Single | 32 | < 5 | 13.3500 | >100 | When manually actuated by encoded LF, the EUT transmits 32 frames of ASK data. Each ASK frame is 13.35 ms in length, containing one 486.4 us pulse, 13 123.2 us timing pulses, one 499.2 us pulse, and 8.8464 ms of Manchester encoded data with 123.2 us / 243.6 us duty. | 7.1 | -20.0
4 | Worst-case ADDED Rolling Mode. See Figure (c) | 60 | 8 | < 1 | 13.3500 | >100 | Same as above. | 7.1 | -20.0
Frame Encoding | (%) | (dB)

Example ORIG Mode Calculation: Duty (%) = (27.675 * 0.1248 ms /0.2392 ms )/100ms)*100
Example ADDED Mode Calculation: Duty (%) = ((0.4864 ms +13*0.1232 ms +0.4992ms +8.8464 ms * 0.1232 ms /0.2436 ms )/100ms )*100
Min. | Cycle
Repetition
Rate (sec)

Max.
No. of
Frames

Total
Transmission
Length (sec)

Max. Frame
Length (ms)

Min.
Frame
Period (ms)
Willow Run Test Labs, LLC, 8501 Beck Road, Building 2227, Belleville, Michigan 48111 USA | Page 10 of 17

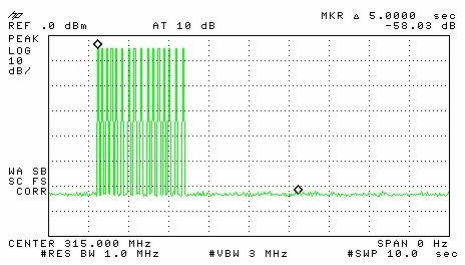
[picture p17: figure]
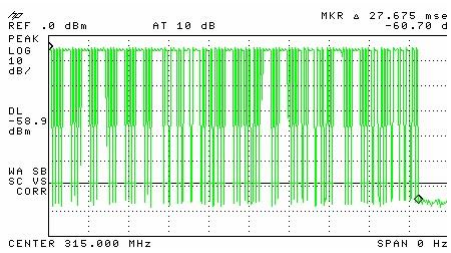
[picture p18: figure]
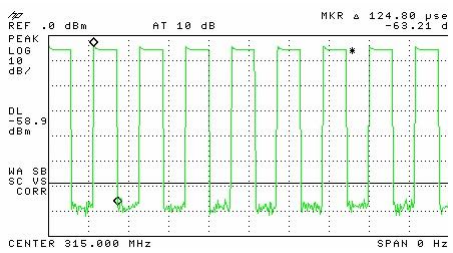
[picture p19: figure]
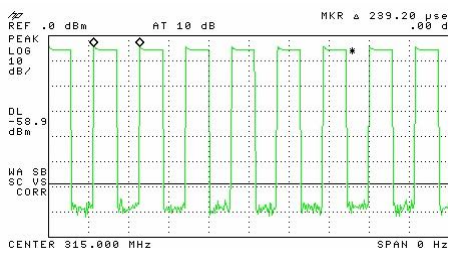
[picture p20: figure]

Figure 5(a): Pulsed Emission Characteristics (Duty Cycle).

Willow Run Test Labs, LLC, 8501 Beck Road, Building 2227, Belleville, Michigan 48111 USA | Page 11 of 17

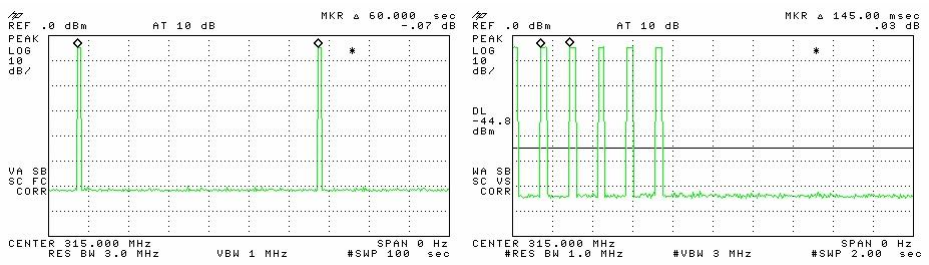
[picture p21: figure]
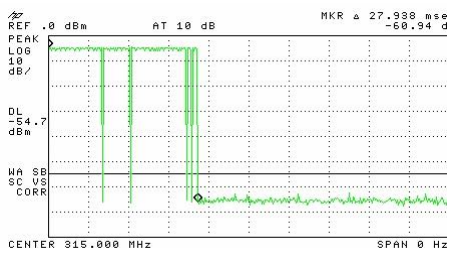
[picture p22: figure]

Figure 5(b): Pulsed Emission Characteristics (Duty Cycle).

Willow Run Test Labs, LLC, 8501 Beck Road, Building 2227, Belleville, Michigan 48111 USA | Page 12 of 17

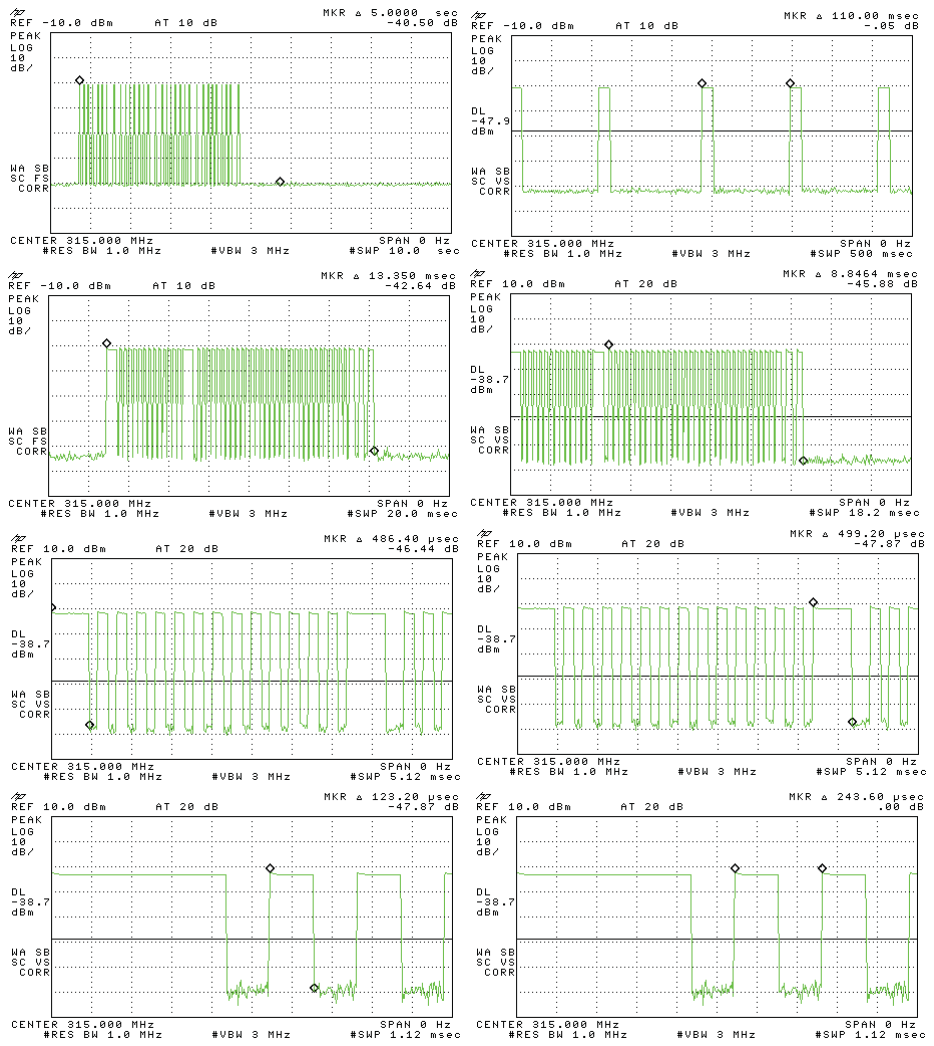
[picture p23: figure]

Figure 5(c): Pulsed Emission Characteristics (Duty Cycle).

Willow Run Test Labs, LLC, 8501 Beck Road, Building 2227, Belleville, Michigan 48111 USA | Page 13 of 17

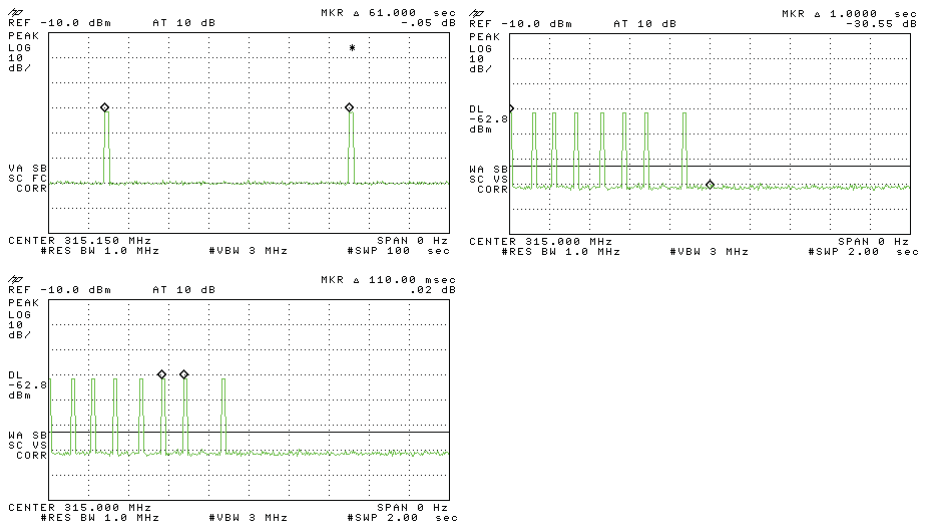
[picture p24: figure]

Figure 5(d): Pulsed Emission Characteristics (Duty Cycle).

Willow Run Test Labs, LLC, 8501 Beck Road, Building 2227, Belleville, Michigan 48111 USA | Page 14 of 17

### 3.2.2 Fundamental Emission Bandwidth

Emission bandwidth (EBW) of the EUT is measured with the device placed in the test mode(s) with the shortest available frame length and minimum frame spacing. Radiated emissions are recorded following the test procedures listed in Section 1.1. The 20 dB EBW is measured as the max-held peak-detected signal when the IF bandwidth is greater than or equal to 1% of the receiver span. For complex modulations other than ASK and FSK, the 99% emission bandwidth per IC test procedures has a different result, and is also separately reported.The results of EBW testing are summarized in Table 4. Plots showing measurements employed to obtain the emission bandwidth reported are provided in Figure 6.

Table 4: Intentional Emission Bandwidth.

### Test Date: 12-Jun-13

Detector | IF Bandwidth Video Bandwidth | Test Engineer:
Pk | 10 kHz | 30 kHz | EUT Mode: Modulated
Meas. Distance: | 10 cm
| | | FCC/IC
# | Mode | Center Frequency (MHz) | 20 dB EBW (MHz) | EBW Limit (MHz)

1 | ASK | 315 | 0.0550 | 0.7875
2

### Joseph Brunett

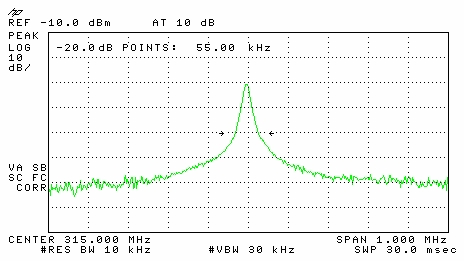
[picture p25: figure]

Figure 6: Intentional Emission Bandwidth.

Willow Run Test Labs, LLC, 8501 Beck Road, Building 2227, Belleville, Michigan 48111 USA | Page 15 of 17

### 3.2.3 Fundamental Emission

Following the test procedures listed in Section 1.1, radiated emissions measurements are made on the EUT for both Horizontal and Vertical polarized fields. Table 5 details the results of these measurements.

Table 5: Fundamental Radiated Emissions.

Frequency Range | | IF Bandwidth | Video Bandwidth | Test Date: | 12-Jun-13
25 MHz ≤ f ≤ 1 000 MHz | | 120 kHz | 300 kHz | Test Engineer: | Joseph Brunett
f > 1 000 MHz | Pk | 1 MHz | 3MHz | EUT Mode: | CW
f > 1 000 MHz | Avg | 1 MHz | 10kHz | Meas. Distance: | 3 meters
FCC/IC
# | Freq. MHz | Ant. Used | Ant. Pol. | Pr (Pk) dBm | Pr (Avg)* dBm | Ka dB/m | Kg dB | E3(Pk) dBµV/m dBµV/m | E3(Avg) | FCC/IC E3(Avg) Lim. dBµV/m | Pass dB | Comments

1 | 315.0 | Dip | H | -14.1 | -30.9 | 18.6 | 33.1 | 78.4 | 61.6 | 67.7 | 6.1
2 | 315.0 | Dip | V | -16.6 | -33.4 | 18.6 | 33.1 | 75.9 | 59.1 | 67.7 | 8.6
3
4
5
6
# | Freq. MHz | DC Supply Voltage | | | Relative Pr (Pk) dBm**

7 | 315.0 | 2.50 | | | -14.7
8 | 315.0 | 2.75 | | | -14.4
9 | 315.0 | 3.00 | | | -14.1
10 | 315.0 | 3.25 | | | -14.1
11 | 315.0 | 3.50 | | | -13.4
*Avg data computed from Peak Measured Data and EUT Duty Cycle. EUT in CW mode. ** EUT in CW mode.

Det
Pk/QPk
Willow Run Test Labs, LLC, 8501 Beck Road, Building 2227, Belleville, Michigan 48111 USA | Page 16 of 17

### 3.3 Unintentional Emissions

### 3.3.1 Transmit Chain Spurious Emissions

The results for the measurement of transmit chain spurious emissions at the nominal voltage and temperature are provided in Table 6. Measurements are performed to 10 times the highest fundamental operating frequency.

Table 6: Transmit Chain Spurious Emissions.

Frequency Range | | IF Bandwidth | Video Bandwidth | 12-Jun-13
25 MHz ≤ f ≤ 1 000 MHz | | 120 kHz | 300 kHz | Joseph Brunett
f > 1 000 MHz | Pk | 1 MHz | 3 MHz | CW
f > 1 000 MHz | Avg | 1 MHz | 10kHz | 3 meters
Transmitter Unintentional Spurious Emissions | FCC/IC
# | Freq. MHz | Ant. Used | Ant. Pol. | Pr (Pk) dBm | Pr (Avg)* dBm | Ka dB/m | Kg dB | E3(Pk) dBµV/m | E3(Avg) dBµV/m | FCC/IC E3lim (Avg) dBµV/m | Pass dB | Comments

1 | 630.0 | Dip | H | -58.5 | -75.3 | 24.4 | 29.8 | 43.1 | 26.3 | 47.7 | 21.3 | flat
2 | 630.0 | Dip | V | -56.2 | -73.0 | 24.4 | 29.8 | 45.4 | 28.6 | 47.7 | 19.0 | end
3 | 945.0 | Dip | H | -47.7 | -64.5 | 28.8 | 26.8 | 61.3 | 44.5 | 47.7 | 3.1 | flat
4 | 945.0 | Dip | V | -50.1 | -66.9 | 28.8 | 26.8 | 58.9 | 42.1 | 47.7 | 5.5 | end
5 | 1260.0 | R-Horn | H | -41.5 | -58.3 | 20.6 | 22.4 | 63.7 | 46.9 | 54.0 | 7.1 | flat
6 | 1575.0 | R-Horn | H | -57.2 | -74.0 | 21.5 | 29.2 | 42.0 | 25.2 | 54.0 | 28.7 | flat
7 | 1890.0 | R-Horn | H | -60.8 | -77.6 | 22.2 | 31.2 | 37.2 | 20.4 | 54.0 | 33.6 | flat
8 | 2205.0 | R-Horn | H | -55.1 | -71.9 | 23.0 | 30.9 | 43.9 | 27.1 | 54.0 | 26.8 | flat
9 | 2520.0 | R-Horn | H | -49.2 | -66.0 | 23.9 | 29.8 | 51.9 | 35.1 | 54.0 | 18.9 | flat
10 | 2835.0 | R-Horn | H | -50.8 | -67.6 | 24.8 | 28.6 | 52.4 | 35.6 | 54.0 | 18.4 | flat
11 | 3150.0 | R-Horn | H | -49.3 | -66.1 | 25.8 | 27.5 | 56.1 | 39.3 | 54.0 | 14.7 | max all, noise
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
*Avg data computed from Peak Measured Data and EUT Duty Cycle. EUT in CW mode.

Det
Pk/QPk
Willow Run Test Labs, LLC, 8501 Beck Road, Building 2227, Belleville, Michigan 48111 USA | Page 17 of 17

Emergency Modes | Consumer Use Modes | Manufacturing & Service Modes
| | | Forced Transmission "Learn Mode" (dealer / plant) | On receipt of a particular LF sequence this Forced transmission allows the interrogation of the sensor in the vehicle factory or dealership
| | | Pressure Re-Measure Mode Mode of Operation Stationary Mode X Wake Mode Drive Mode Low battery Off Mode | Transmitter in normal operation when a low battery flag has been set - wheel is rotating Transmitter in normal operation - wheel is rotating Transmitter in normal operation - wheel is rotating Explanation | Transmission rate depending on Drive mode X Forced Transmission as required X Transmission rate every 30secs X Transmission rate every 60secs X Alarm transmission as required Frequency of Transmission X At the start of wheel rotation X No transmissions X

Part is in an off state, No transmissions, Exit by LF or P

First transmittion in normal operation - when wheel is rotating then moves into drive mode Fartory Drive Mode

Transmitter in normal operation and meassuresment sample which is less then 5 counts than the pervious sample
