AjayaDahal/TPMS-2018-Toyota-Yaris-iA/hardware/docs/tpms_panel_fit_template_1to1.pdf

# TPMS panel - 1:1 fit template (front view, as seen from the driver's seat)

outline accepted from the in-car fit, board 1 mm smaller on sides and bottom - generated 2026-11-09 from tpms_panel.kicad_pcb - print at 100% / Actual size, NOT 'Fit to page'

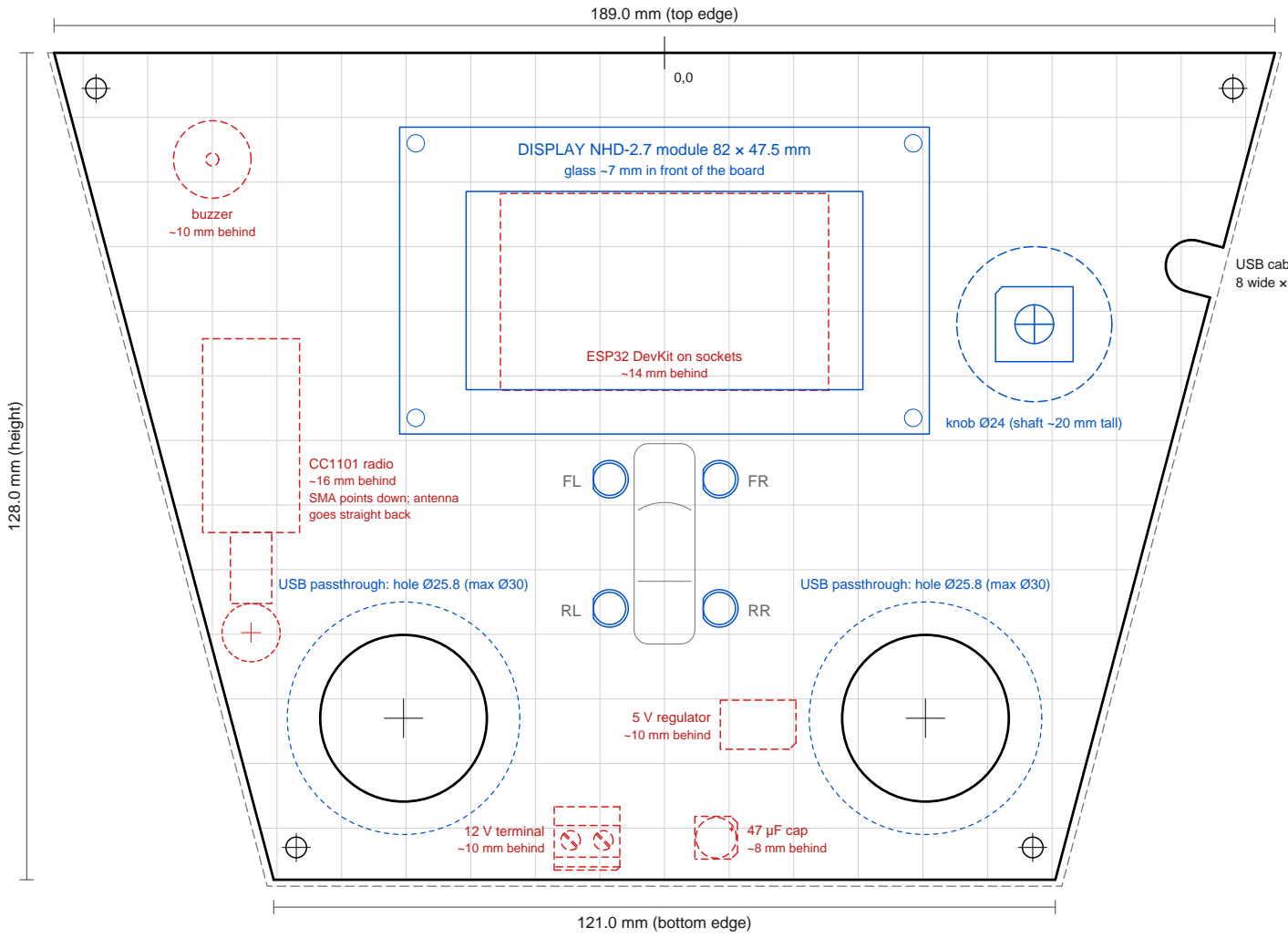
[picture p26: figure]
ESP32 DevKit on sockets; ~14 mm behind; CC1101 radio ~16 mm behind SMA points down; antenna goes straight back; 12 V terminal ~10 mm behind; 5 V regulator ~10 mm behind; buzzer ~10 mm behind; 47 µF cap ~8 mm behind; knob Ø24 (shaft ~20 mm tall); 189.0 mm (top edge); 121.0 mm (bottom edge); 128.0 mm (height)

DISPLAY NHD-2.7 module 82 × 47.5 mm | glass ~7 mm in front of the board | | 0,0
USB passthrough: hole Ø25.8 (max Ø30) | USB passthrough: hole Ø25.8 (max Ø30)

USB cable slot (car USB port)
8 wide × 8 deep, centre 34 mm below top

100 mm (measure: must be exactly 100 mm)

4 in (must be exactly 4 inches) thick black = cut line (board edge, USB holes); small circles = M3 holes grey dashed = car opening (paper fit); the board is 1 mm inside it
blue = front parts: display, LEDs, knob (dashed), USB nut (dashed) red dashed = tall parts behind the panel (depth noted)
grey = silkscreen; light grid = 10 mm
Feature positions, mm from top-centre (x right, y down, front view): display module centre: (+0, 35.25)
knob / encoder shaft: (+57.25, 42)
LED FL: (-8.5, 66)
LED FR: (+8.5, 66)
LED RL: (-8.5, 86)
LED RR: (+8.5, 86)
USB socket 1: (-40.4, 103)

USB socket 2: (+40.4, 103) mount hole H1: (-88, 5.5)
mount hole H2: (+88, 5.5)
mount hole H3: (-57, 123)
mount hole H4: (+57, 123)

How to use: print at 100% / Actual size and check both bars with a ruler. Cut along the thick black lines and hold it in the dash from the driver's side. Grey dashed = the opening it was matched to in the car (2026-11-09). Sticks out in front: display ~7 mm, LEDs ~9 mm, knob ~22 mm.
Behind: up to ~16 mm; the CC1101 antenna connector points down and the antenna goes straight back into the pocket (90 deg SMA adapter or cable).

# TPMS panel - 1:1 outline only (trace onto cardboard or cut)

outline accepted from the in-car fit, board 1 mm smaller on sides and bottom - generated 2026-11-09 - print at 100% / Actual size

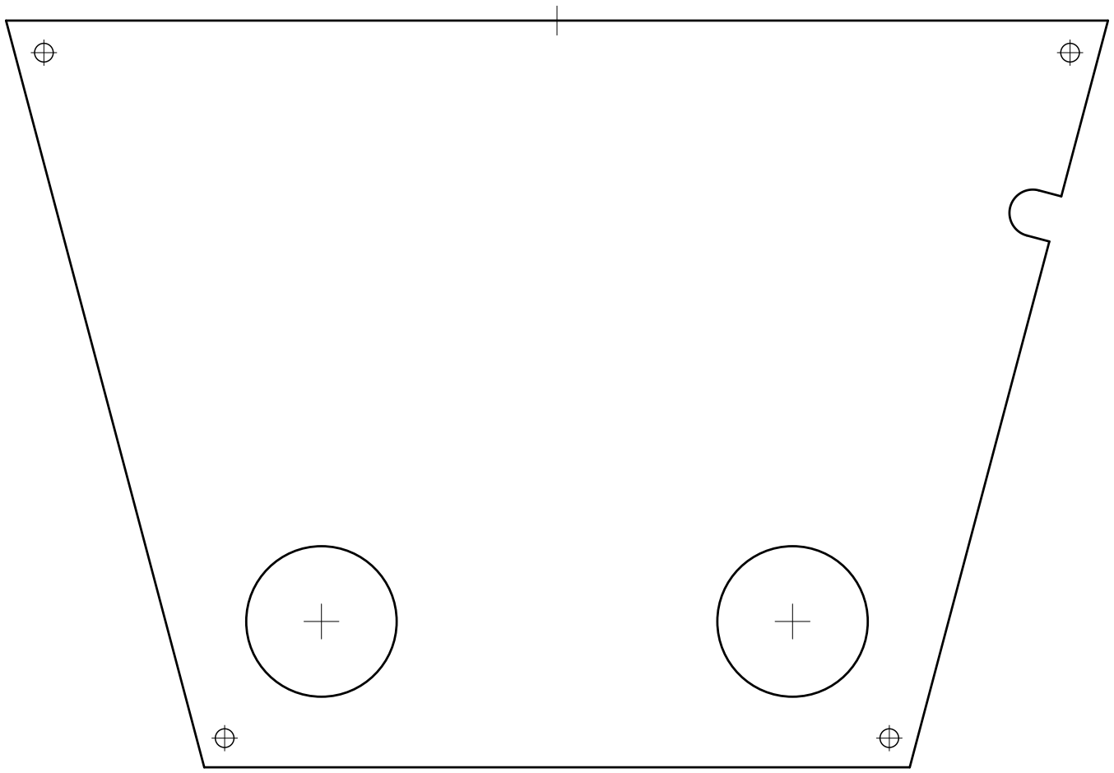
[picture p27: figure]

100 mm (measure: must be exactly 100 mm)

4 in (must be exactly 4 inches)
