AjayaDahal/TPMS-2018-Toyota-Yaris-iA/hardware/docs/render_iso.png

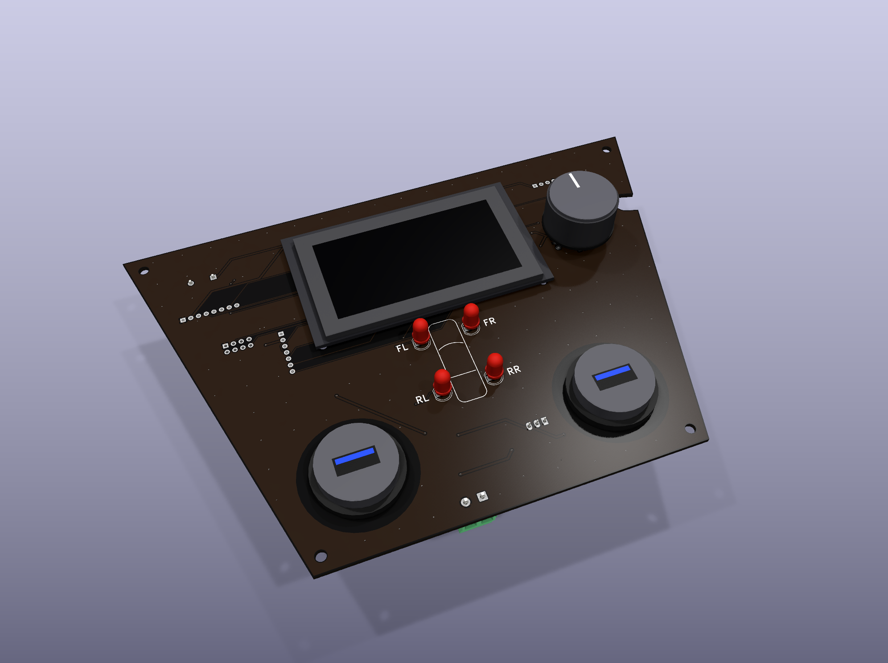
hardware/docs/render_iso.png
