AjayaDahal/TPMS-2018-Toyota-Yaris-iA/hardware/docs/tpms_panel.step

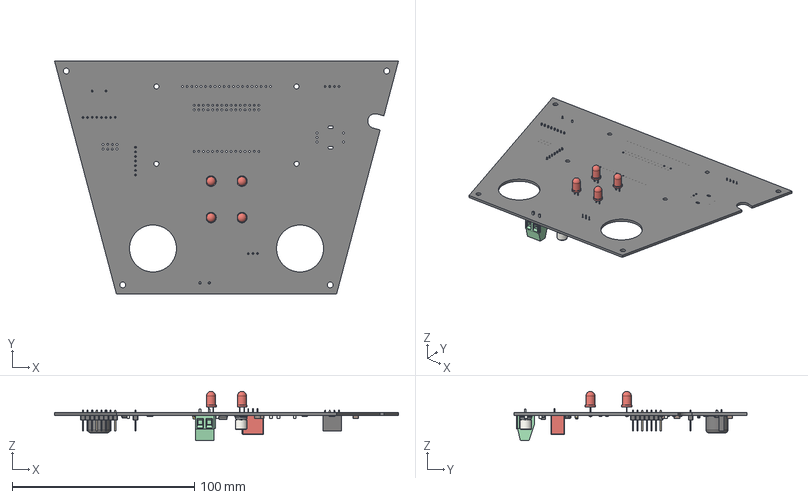
[picture p29: CAD file, 2026-11-10]
hardware/docs/tpms_panel.step
189.0 x 128.0 x 27.1 mm
LED_D5.0mm x 4
CP_EIA_3216_18_Kemet_A
TerminalBlock_Phoenix_MKDS-1,5-2-5.08_1x02_P5.08mm_Horizontal
C_1206_3216Metric x 10
R_1206_3216Metric x 15
D_SOD-123
SOT-23
PinSocket_1x04_P2.54mm_Vertical
SOT-223
PinHeader_1x08_P254mm_Vertical
Converter_DCDC_TRACO_TSR_1_THT
D_SMA x 2
PinHeader_1x07_P254mm_Vertical
Buzzer_12x95RM76
CP_Elec_63x77
tpms_panel_PCB
