AjayaDahal/TPMS-2018-Toyota-Yaris-iA/hardware/docs/tpms_panel_pcb_front.pdf

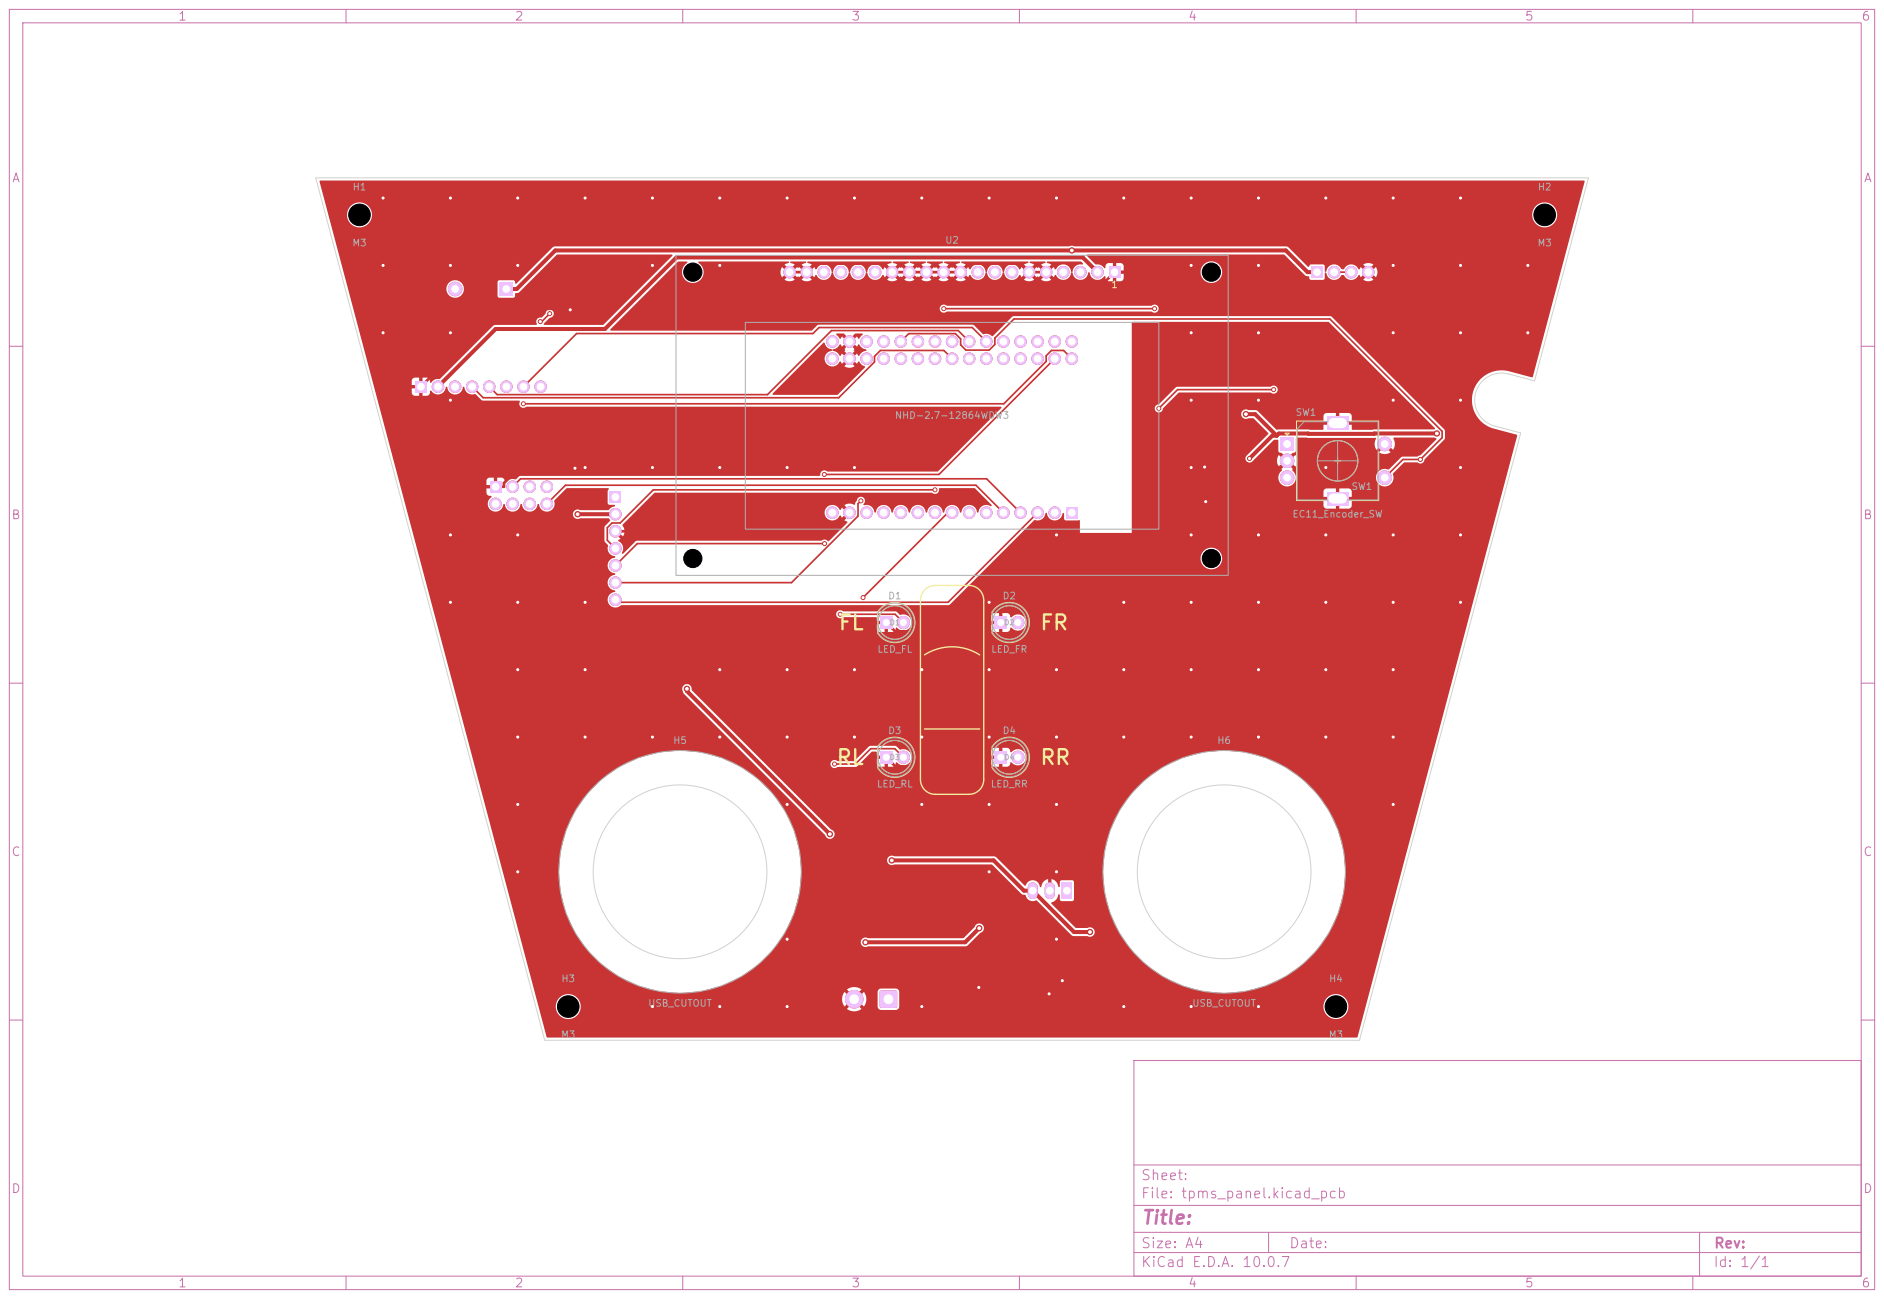
[picture p30: page 1]

Size: A4 | Rev:
KiCad E.D.A. 10.0.7 | Id: 1/1
