AjayaDahal/TPMS-2018-Toyota-Yaris-iA/hardware/docs/tpms_panel_schematic.pdf

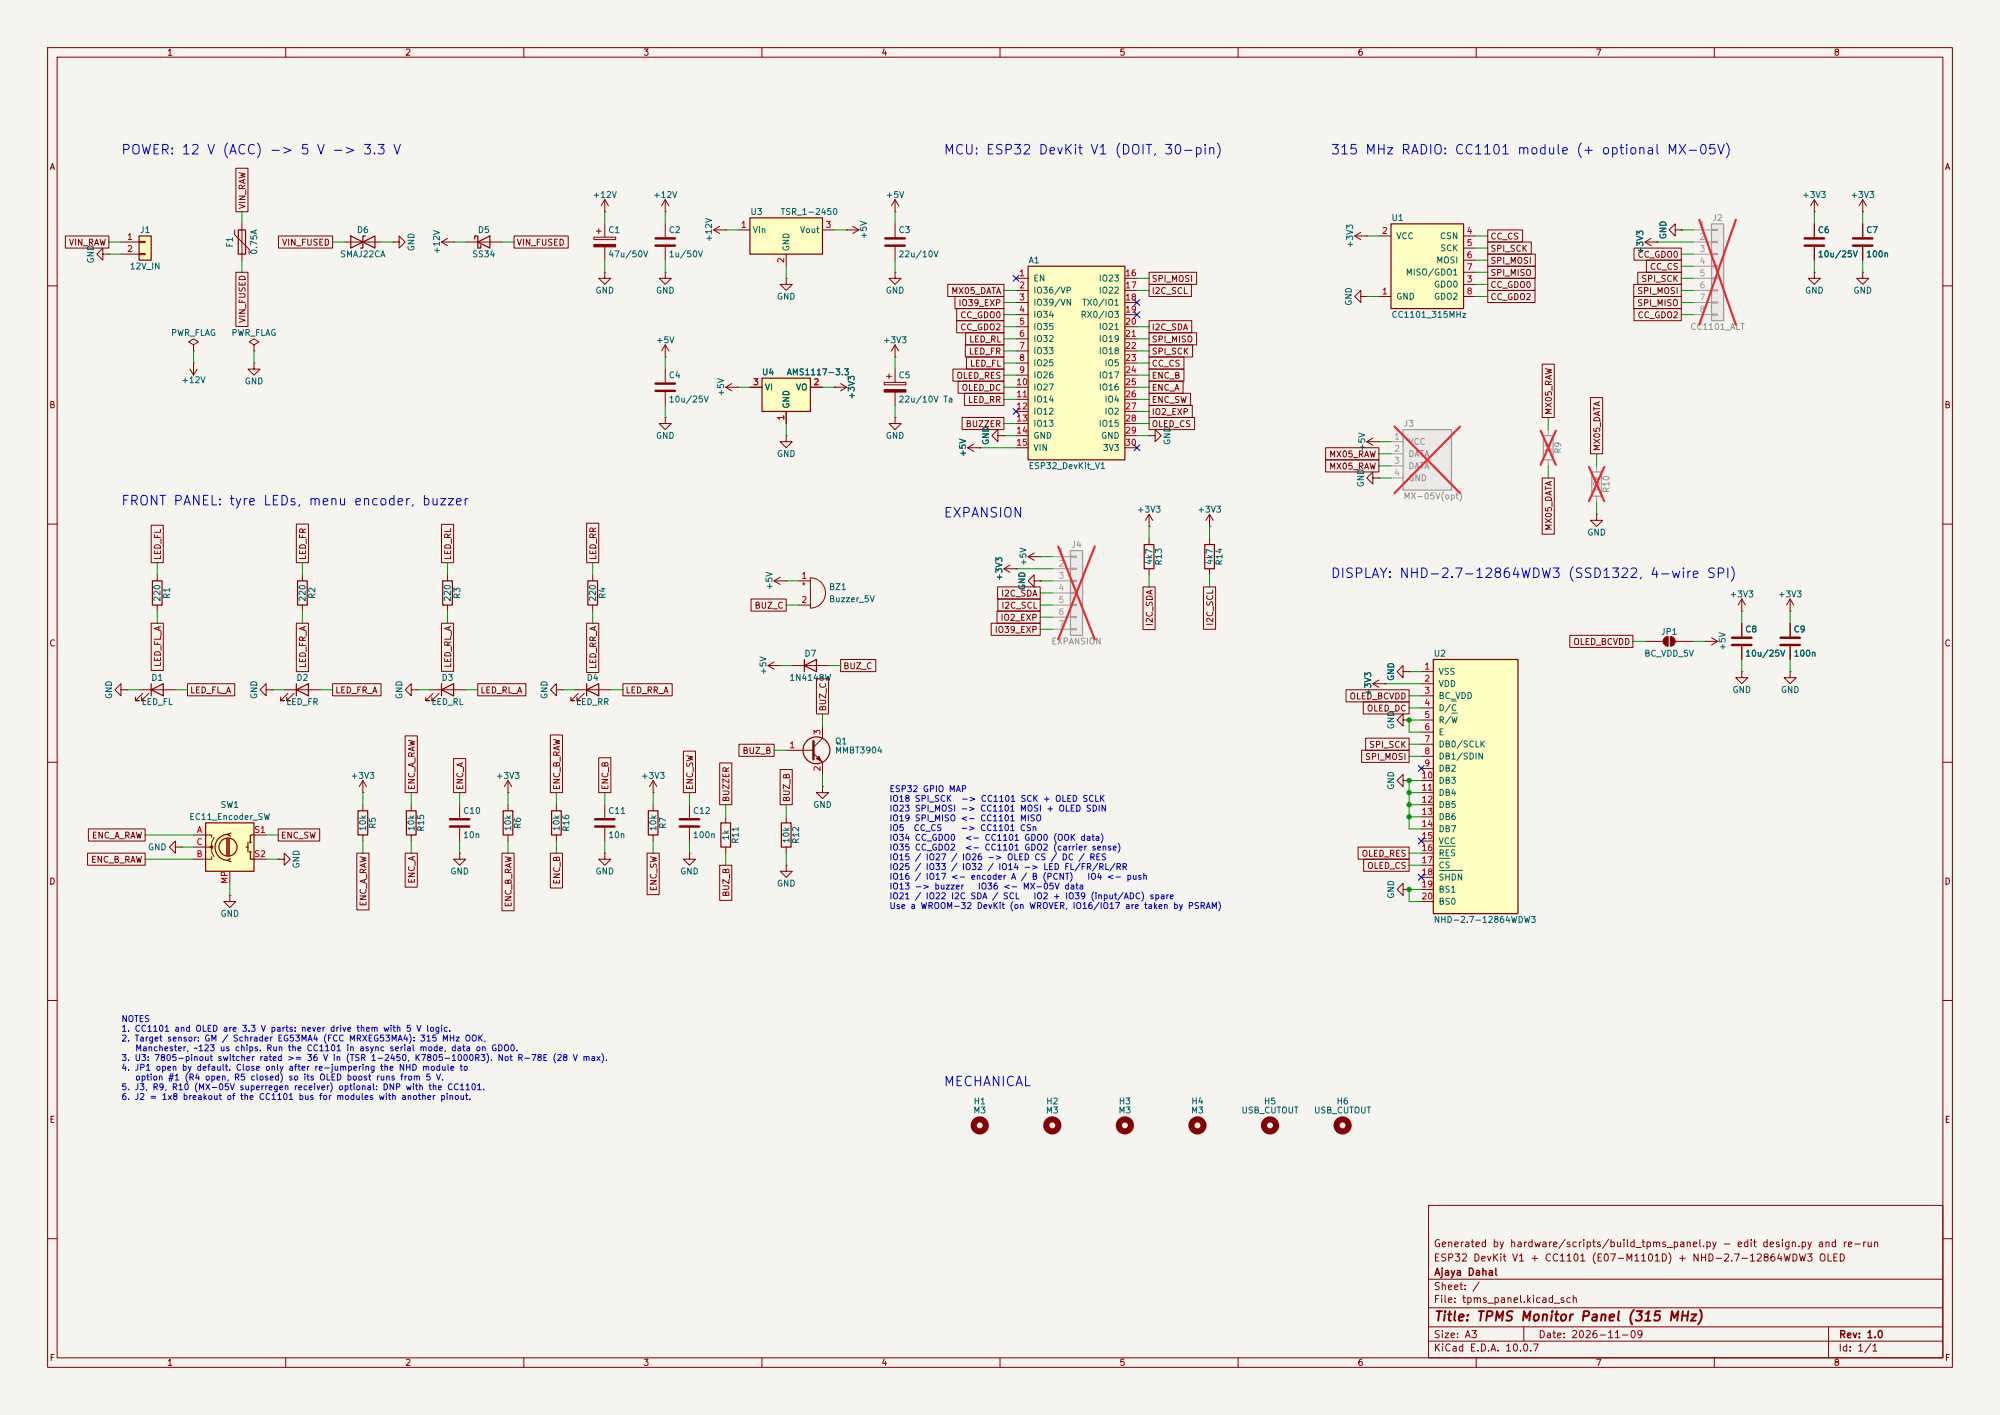
[picture p31: page 1]

Generated by hardware/scripts/build_tpms_panel.py - edit design.py and re-run GND

FRONT PANEL: tyre LEDs, menu encoder, buzzer

DISPLAY: NHD-2.7-12864WDW3 (SSD1322, 4-wire SPI)

ESP32 GPIO MAP
IO18 SPI_SCK -> CC1101 SCK + OLED SCLK
IO23 SPI_MOSI -> CC1101 MOSI + OLED SDIN
IO19 SPI_MISO <- CC1101 MISO
IO34 CC_GDO0 <- CC1101 GDO0 (OOK data)
IO35 CC_GDO2 <- CC1101 GDO2 (carrier sense)
IO15 / IO27 / IO26 -> OLED CS / DC / RES
IO25 / IO33 / IO32 / IO14 -> LED FL/FR/RL/RR

NOTES
1. CC1101 and OLED are 3.3 V parts: never drive them with 5 V logic. 2. Target sensor: GM / Schrader EG53MA4 (FCC MRXEG53MA4): 315 MHz OOK,

Manchester, ~123 us chips. Run the CC1101 in async serial mode, data on GDO0. 3. U3: 7805-pinout switcher rated >= 36 V in (TSR 1-2450, K7805-1000R3). Not R-78E (28 V max). 4. JP1 open by default. Close only after re-jumpering the NHD module to

option #1 (R4 open, R5 closed) so its OLED boost runs from 5 V. 5. J3, R9, R10 (MX-05V superregen receiver) optional: DNP with the CC1101. 6. J2 = 1x8 breakout of the CC1101 bus for modules with another pinout.

ESP32 DevKit V1 + CC1101 (E07-M1101D) + NHD-2.7-12864WDW3 OLED
Ajaya Dahal
Sheet: /
File: tpms_panel.kicad_sch
Title: TPMS Monitor Panel (315 MHz)

Size: A3 | Rev: 1.0 | F Date: 2026-11-09
KiCad E.D.A. 10.0.7 | Id: 1/1
