AjayaDahal/TPMS-2018-Toyota-Yaris-iA/hardware/tpms_panel.kicad_pcb

## KiCad design hardware/tpms_panel.kicad_pcb (2026-11-10)

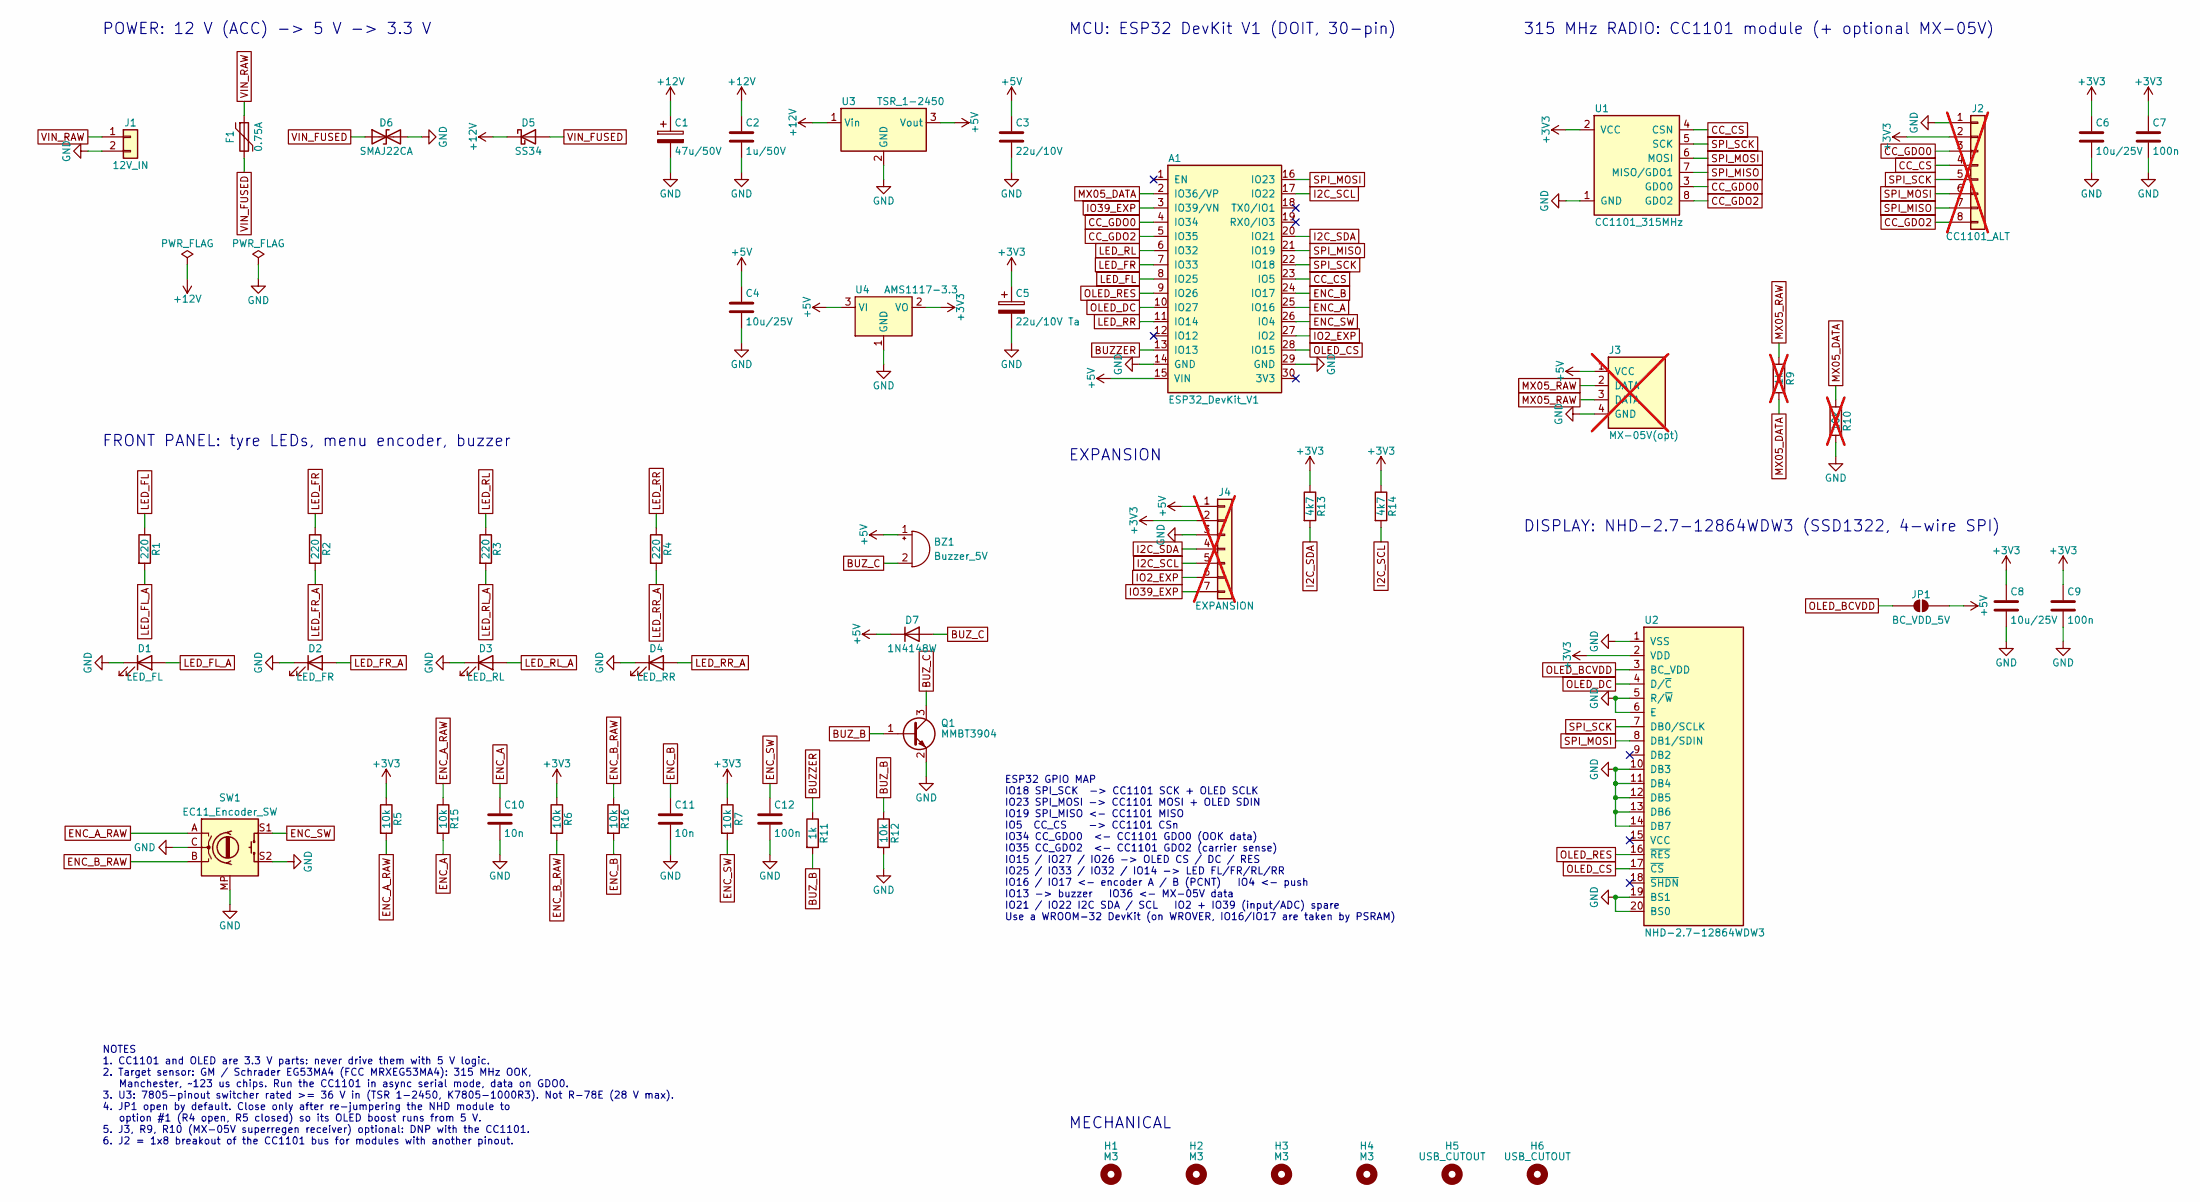
[picture p32: schematic tpms_panel.kicad_sch, TPMS Monitor Panel (315 MHz)]

Parts:
A1: ESP32_DevKit_V1; ESP32_DOIT_DevKit_V1_30pin; MPN DOIT ESP32 DEVKIT V1 30-pin + 2x 1x15 2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
BZ1: Buzzer_5V; Buzzer_12x9.5RM7.6; MPN 12 mm 5 V active magnetic buzzer, 7.6 m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
C1: 47u/50V; CP_Elec_6.3x7.7; MPN Panasonic EEE-FK1H470XP
C2: 1u/50V; C_1206_3216Metric
C3: 22u/10V; C_1206_3216Metric
C4, C6, C8: 10u/25V; C_1206_3216Metric
C5: 22u/10V Ta; CP_EIA-3216-18_Kemet-A_HandSolder; MPN KEMET T491A226K010AT
C7, C9, C12: 100n; C_1206_3216Metric
C10, C11: 10n; C_1206_3216Metric
D1: LED_FL; LED_D5.0mm; MPN 5 mm LED
D2: LED_FR; LED_D5.0mm; MPN 5 mm LED
D3: LED_RL; LED_D5.0mm; MPN 5 mm LED
D4: LED_RR; LED_D5.0mm; MPN 5 mm LED
D5: SS34; D_SMA; MPN SS34
D6: SMAJ22CA; D_SMA; MPN Littelfuse SMAJ22CA
D7: 1N4148W; D_SOD-123; MPN 1N4148W
F1: 0.75A; Fuse_1812_4532Metric; MPN Bourns MF-MSMF075/24X-2
H1, H2, H3, H4: M3; MountingHole_3.2mm_M3
H5, H6: USB_CUTOUT; USB_PanelMount_Cutout; MPN USB 3.0 panel-mount passthrough cable, 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
J1: 12V_IN; TerminalBlock_Phoenix_MKDS-1,5-2-5.08_1x02_P5.08mm_Horizont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; MPN Phoenix MKDS 1,5/2-5,08 (1715721)
J2: CC1101_ALT; PinHeader_1x08_P2.54mm_Vertical; MPN 1x8 2.54 mm pin header; not fitted
J3: MX-05V(opt); PinSocket_1x04_P2.54mm_Vertical; MPN 1x4 2.54 mm female header; not fitted
J4: EXPANSION; PinHeader_1x07_P2.54mm_Vertical; MPN 1x7 2.54 mm pin header; not fitted
JP1: BC_VDD_5V; SolderJumper-2_P1.3mm_Open_RoundedPad1.0x1.5mm
Q1: MMBT3904; SOT-23; MPN MMBT3904
R1, R2, R3, R4: 220; R_1206_3216Metric
R5, R6, R7, R12, R15, R16: 10k; R_1206_3216Metric
R9: 1k; R_1206_3216Metric; not fitted
R10: 10k; R_1206_3216Metric; not fitted
R11: 1k; R_1206_3216Metric
R13, R14: 4k7; R_1206_3216Metric
SW1: EC11_Encoder_SW; RotaryEncoder_Alps_EC11E-Switch_Vertical_H20mm; MPN EC11 rotary encoder with push switch (A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
U1: CC1101_315MHz; CC1101_E07-M1101D_Socket; MPN EBYTE E07-M1101D-SMA (CC1101; 433 MHz-t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
U2: NHD-2.7-12864WDW3; MPN Newhaven NHD-2.7-12864WDW3 + 1x20 2.54 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
U3: TSR_1-2450; Converter_DCDC_TRACO_TSR-1_THT; MPN TRACO TSR 1-2450 (6.5-36 V in; alt. Mor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
U4: AMS1117-3.3; SOT-223-3_TabPin2; MPN AMS1117-3.3

Connections:
+3V3: C5.1, C6.1, C7.1, C8.1, C9.1, J2.2, J4.2, R5.1, R6.1, R7.1, R13.1, R14.1, U1.2 (VCC), U2.2 (VDD), U4.2 (VO)
+5V: A1.15 (VIN), BZ1.1 (+), C3.1, C4.1, D7.1 (K), J3.1 (VCC), J4.1, JP1.2 (B), U3.3 (Vout), U4.3 (VI)
+12V: C1.1, C2.1, D5.1 (K), U3.1 (Vin)
BUZZER: A1.13 (IO13), R11.1
BUZ_B: Q1.1 (B), R11.2, R12.1
BUZ_C: BZ1.2 (-), D7.2 (A), Q1.3 (C)
CC_CS: A1.23 (IO5), J2.4, U1.4 (CSN)
CC_GDO0: A1.4 (IO34), J2.3, U1.3 (GDO0)
CC_GDO2: A1.5 (IO35), J2.8, U1.8 (GDO2)
ENC_A: A1.25 (IO16), C10.1, R15.2
ENC_A_RAW: R5.2, R15.1, SW1.A
ENC_B: A1.24 (IO17), C11.1, R16.2
ENC_B_RAW: R6.2, R16.1, SW1.B
ENC_SW: A1.26 (IO4), C12.1, R7.2, SW1.S1
GND: A1.14 (GND), A1.29 (GND), C1.2, C2.2, C3.2, C4.2, C5.2, C6.2, C7.2, C8.2, C9.2, C10.2, C11.2, C12.2, D1.1 (K), D2.1 (K), D3.1 (K), D4.1 (K), D6.2 (A2), J1.2, J2.1, J3.4 (GND), J4.3, Q1.2 (E), R10.2, R12.2, SW1.C, SW1.MP, SW1.S2, U1.1 (GND), U2.1 (VSS), U2.5 (R/~W), U2.6 (E), U2.10 (DB3), U2.11 (DB4), U2.12 (DB5), U2.13 (DB6), U2.14 (DB7), U2.19 (BS1), U2.20 (BS0), U3.2 (GND), U4.1 (GND)
I2C_SCL: A1.17 (IO22), J4.5, R14.2
I2C_SDA: A1.20 (IO21), J4.4, R13.2
IO2_EXP: A1.27 (IO2), J4.6
IO39_EXP: A1.3 (IO39/VN), J4.7
LED_FL: A1.8 (IO25), R1.1
LED_FL_A: D1.2 (A), R1.2
LED_FR: A1.7 (IO33), R2.1
LED_FR_A: D2.2 (A), R2.2
LED_RL: A1.6 (IO32), R3.1
LED_RL_A: D3.2 (A), R3.2
LED_RR: A1.11 (IO14), R4.1
LED_RR_A: D4.2 (A), R4.2
MX05_DATA: A1.2 (IO36/VP), R9.2, R10.1
MX05_RAW: J3.2 (DATA), J3.3 (DATA), R9.1
OLED_BCVDD: JP1.1 (A), U2.3 (BC_VDD)
OLED_CS: A1.28 (IO15), U2.17 (~CS)
OLED_DC: A1.10 (IO27), U2.4 (D/~C)
OLED_RES: A1.9 (IO26), U2.16 (~RES)
SPI_MISO: A1.21 (IO19), J2.7, U1.7 (MISO/GDO1)
SPI_MOSI: A1.16 (IO23), J2.6, U1.6 (MOSI), U2.8 (DB1/SDIN)
SPI_SCK: A1.22 (IO18), J2.5, U1.5 (SCK), U2.7 (DB0/SCLK)
VIN_FUSED: D5.2 (A), D6.1 (A1), F1.2
VIN_RAW: F1.1, J1.1

Notes on the sheet:
POWER: 12 V (ACC) -> 5 V -> 3.3 V
MCU: ESP32 DevKit V1 (DOIT, 30-pin)
315 MHz RADIO: CC1101 module (+ optional MX-05V)
DISPLAY: NHD-2.7-12864WDW3 (SSD1322, 4-wire SPI)
FRONT PANEL: tyre LEDs, menu encoder, buzzer
EXPANSION
MECHANICAL
ESP32 GPIO MAP IO18 SPI_SCK -> CC1101 SCK + OLED SCLK IO23 SPI_MOSI -> CC1101 MOSI + OLED SDIN IO19 SPI_MISO <- CC1101 MISO IO5 CC_CS -> CC1101 CSn IO34 CC_GDO0 <- CC1101 GDO0 (OOK data) IO35 CC_GDO2 <- CC1101 GDO2 (carrier sense) IO15 / IO27 / IO26 -> OLED CS / DC / RES IO25 / IO33 / IO32 / IO14 -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
NOTES 1. CC1101 and OLED are 3.3 V parts: never drive them with 5 V logic. 2. Target sensor: GM / Schrader EG53MA4 (FCC MRXEG53MA4): 315 MHz OOK, Manchester, ~123 us chips. Run the CC1101 in async serial mode, data on GDO0. 3. U3: 7805-pinout switcher rated >= 36 V in (TSR 1-2450, K7805-1000R3). No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

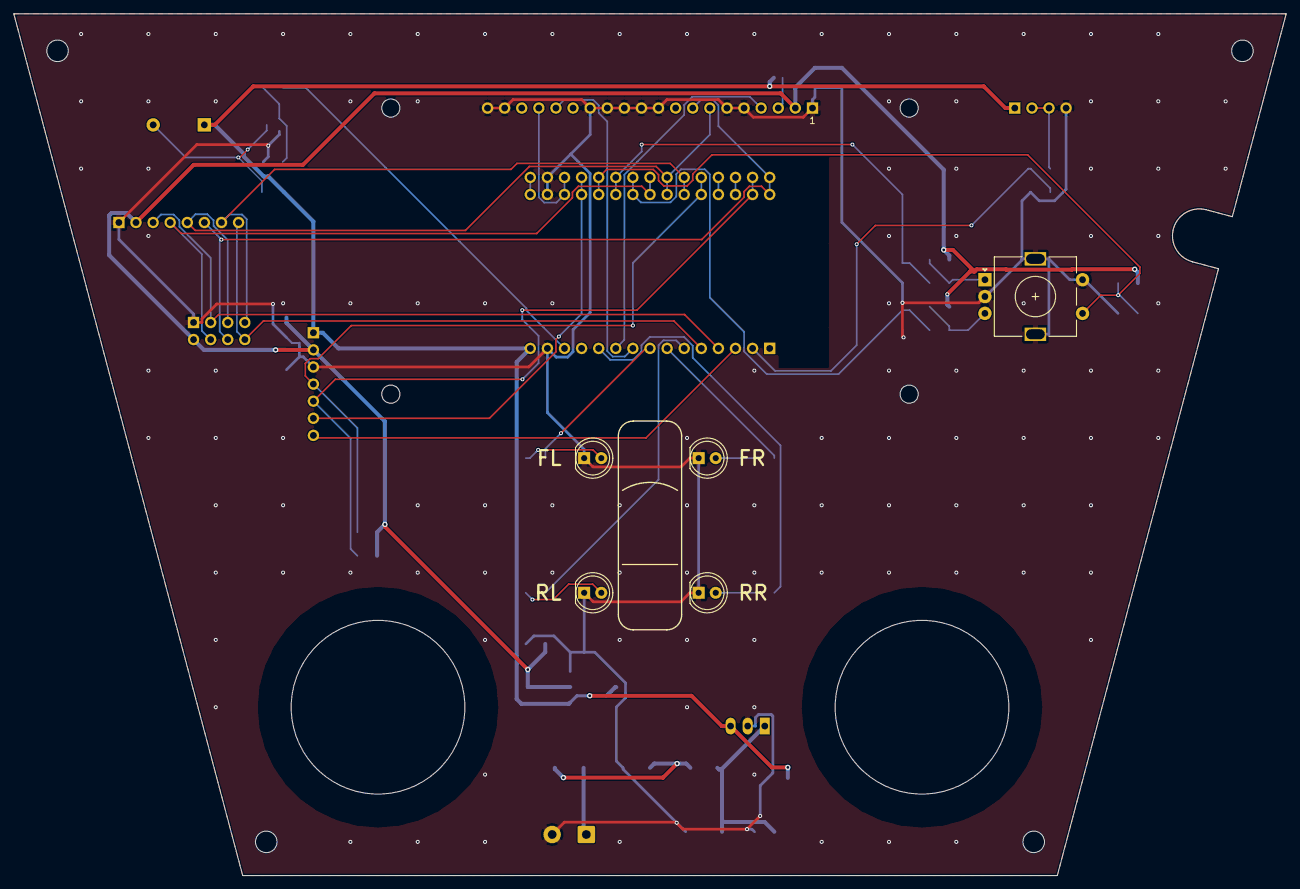
[picture p33: board tpms_panel.kicad_pcb from above]

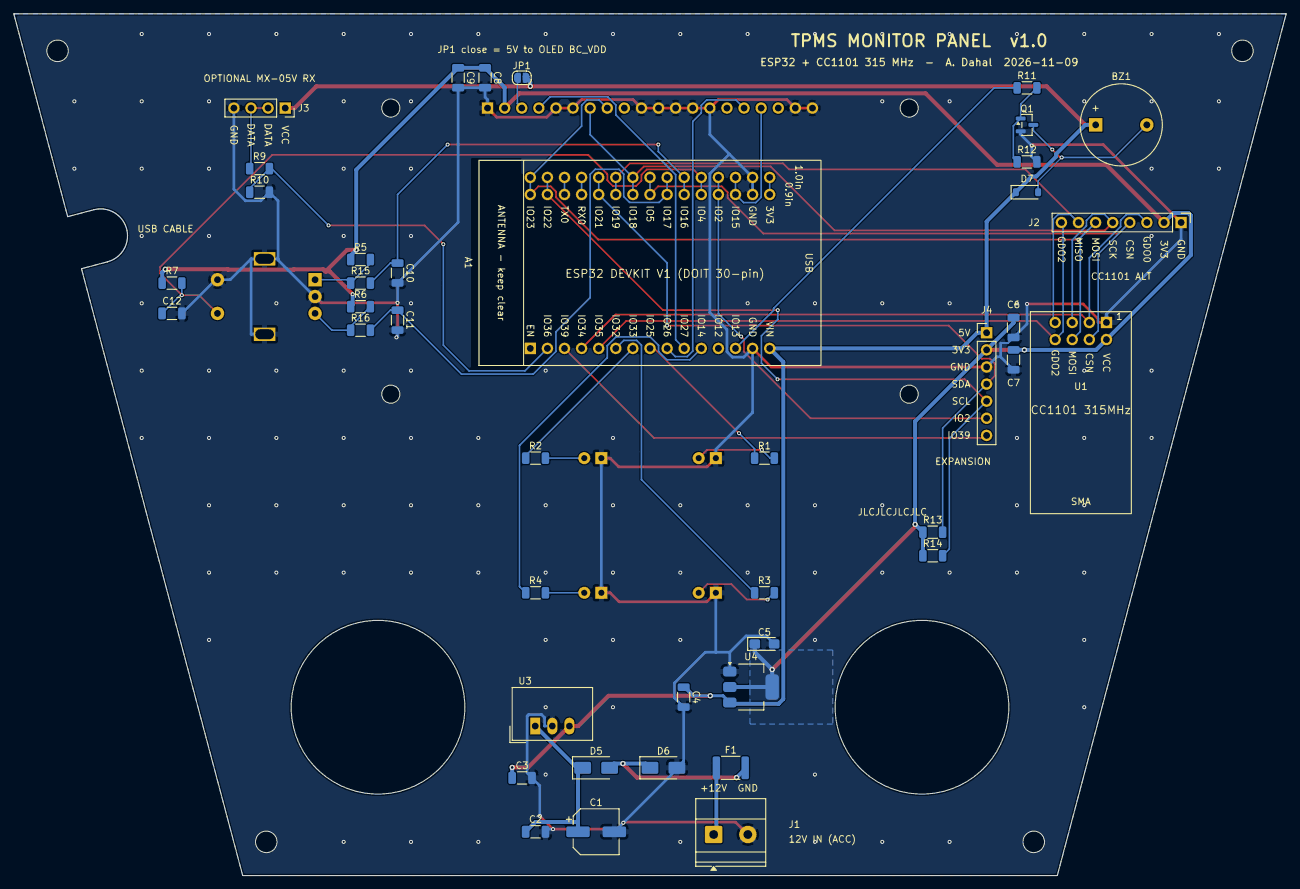
[picture p34: board tpms_panel.kicad_pcb from below]

Board: 2 copper layers, 189.0 x 128.0 mm, 54 parts (42 on the bottom side), 38 nets.
