AjayaDahal/TPMS-2018-Toyota-Yaris-iA/(commit log)

2026-11-05 Add TPMS monitor panel hardware (KiCad 10) and JLCPCB outputs
    Script-generated KiCad project for a 315 MHz TPMS dash panel: ESP32 DevKit V1,
    CC1101 (EBYTE E07-M1101D) receiver, NHD-2.7-12864WDW3 OLED, EC11 encoder,
    4 tyre LEDs, 12 V ACC input.
    - hardware/scripts: generator (schematic, board, autorouting, DRC, outputs)
    - hardware/production: Gerbers/drills (DRAFT until panel dimensions are
    confirmed) and BOM
    - hardware/docs: schematic/PCB PDFs, renders, STEP, design audit
    - ERC 0/0, DRC 0 errors / 0 warnings / 0 unconnected, schematic parity clean
    [tpms_panel-B_Cu.gbl, tpms_panel-B_Mask.gbs, tpms_panel-B_Paste.gbp, tpms_panel-B_Silkscreen.gbo, tpms_panel-Edge_Cuts.gm1, tpms_panel-F_Cu.gtl, tpms_panel-F_Mask.gts, tpms_panel-F_Paste.gtp]
2026-11-05 Add premortem, bring-up firmware and 315 MHz sniffer
    The 2018 Yaris iA (Mazda2) uses an undocumented TPMS sensor (likely Mazda
    BHA4-37-140 / GDDL-37-140, TRW), not the GM/Schrader EG53MA4 from the report,
    so decoding the car's sensors is the main project risk.
    - docs/premortem.md: ranked failure modes, warning signs, mitigations
    - firmware/bringup: ESP32 self-test (CC1101 ID/RX/noise floor, OLED, LEDs,
    buzzer, encoder) and a protocol-agnostic 315 MHz sniffer (OOK + 3 FSK
    profiles, Manchester / differential Manchester / raw chip output)
    - host unit tests for the decoder (8 cases); they caught a bug where
    differential Manchester dropped the last bit of each frame (fixed)
    - hardware/READ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
    [cc1101.cpp, cc1101.h, main.cpp, pins.h, rf.h, rf_capture.cpp, rf_decode.cpp]
2026-11-05 Correct premortem for indirect TPMS; decode the installed EG53MA4 sensors
    The Yaris iA's own TPMS is indirect (ABS wheel speeds, no wheel sensors);
    four GM/Schrader EG53MA4 sensors were added to the tyres and this panel is
    their receiver. The protocol is therefore known; the previous premortem's
    "unknown factory sensor" risk was wrong and is removed.
    - firmware/bringup: EG53MA4 decoder (slicing as rtl_433's
    OOK_PULSE_MANCHESTER_ZEROBIT, 123 us / 300 us reset; frame checks as
    rtl_433's schrader_EG53MA4: 120 bits, checksum, ID, pressure x25 mbar,
    temperature F); OLED sensor table and serial readout
    - host tests: EG53MA4 frame, repeats, bad checksum, truncated frame
    - docs/premortem.md r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
    [eg53ma4.cpp, eg53ma4.h, main.cpp, rf.h]
2026-11-05 Add 1:1 printable fit template (US Letter) for test-fitting the panel
    hardware/docs/tpms_panel_fit_template_1to1.pdf is generated from the board
    file by the build (or --template-only): page 1 is the annotated front view
    (cut line, USB holes, mounting holes, display/LEDs/knob, tall parts behind
    the panel with depths, dimensions, feature coordinates, 100 mm and 4 in
    check bars); page 2 is the plain outline for tracing. Small dependency-free
    PDF writer; PrintScaling /None so viewers default to actual size. Verified
    with pdfplumber: 191.000 / 123.000 x 129.000 mm outline, 22.000 mm holes.
2026-11-09 Move CC1101 so its antenna connector points into the console pocket
    In-car template photos show the panel fits the console opening under the
    HVAC controls, with its top edge right under the HVAC unit, so the old
    top-left SMA (pointing at the top edge) had no room for an antenna or
    cable. The radio now sits mid-left with the SMA pointing down (end ~85 mm
    from the top), ready for a 90 deg adapter so the antenna goes straight back
    into the pocket. Buzzer driver and J2 moved to the freed top-left, J4 is
    now vertical beside the radio; the DevKit's USB plug gets ~60 mm of room.
    ERC 0/0, routed, DRC 0 errors / 0 warnings / 0 unconnected / 0 parity;
    Gerbers re-checked independently. README checklis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
    [tpms_panel-B_Cu.gbl, tpms_panel-B_Mask.gbs, tpms_panel-B_Paste.gbp, tpms_panel-B_Silkscreen.gbo, tpms_panel-Edge_Cuts.gm1, tpms_panel-F_Cu.gtl, tpms_panel-F_Mask.gts, tpms_panel-F_Paste.gtp]
2026-11-10 Accept outline from in-car fit; add USB cable slot; final Gerber zip
    The 1:1 paper template matched the console opening under the HVAC controls
    (2026-11-09 photos; a 117.3 mm caliper span along the left trim agrees).
    Outline accepted as-is with FIT_CLEARANCE = 1 mm off the left, right and
    bottom edges (board 189 x 128 mm) so it can't come out oversized; gaps go
    to a later 3D-printed bezel/chassis. DIMENSIONS_CONFIRMED = True, so the
    order file is now production/tpms_panel_gerbers_jlcpcb.zip.
    - right-edge notch is now a U-shaped USB cable slot (8 mm wide x 8 mm
    deep, centred 34 mm below the top) for the car's own USB port cable
    - copper cleared to 31 mm around the USB holes (step-drill up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
    [tpms_panel-B_Cu.gbl, tpms_panel-B_Mask.gbs, tpms_panel-B_Paste.gbp, tpms_panel-B_Silkscreen.gbo, tpms_panel-Edge_Cuts.gm1, tpms_panel-F_Cu.gtl, tpms_panel-F_Mask.gts, tpms_panel-F_Paste.gtp]
2026-11-10 Plan the two USB holes for panel-mount USB passthrough cables
    The two front USB holes take panel-mount USB 3.0 passthroughs (female
    socket in front, male plug behind): one into the car's USB port, one into
    a flush 12 V USB charger. Photo estimate: ~20 mm thread (M20/PG13.5
    class) and ~28 mm hex, so the 22 mm holes stay.
    - USB cut-out footprint: courtyards on both sides at 32 mm, so DRC keeps
    parts out from under the flange / hex nut (verified: C5 at its old spot
    is now flagged); C5 moved 1.9 mm toward U4 to clear the left socket
    - BOM lists the passthrough cable (buy 2) on the cut-out line
    - README: passthrough assembly notes (90 deg USB-A adapters and a flush
    charger because the car'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
    [tpms_panel-B_Cu.gbl, tpms_panel-B_Mask.gbs, tpms_panel-B_Paste.gbp, tpms_panel-B_Silkscreen.gbo, tpms_panel-Edge_Cuts.gm1, tpms_panel-F_Cu.gtl, tpms_panel-F_Mask.gts, tpms_panel-F_Paste.gtp]
2026-11-10 Resize USB holes to 25.8 mm for the measured M25 passthrough thread
    The passthrough socket's thread measures 25.16 mm with a caliper (the
    earlier ~20 mm photo estimate was wrong), so the 22 mm holes would not
    have fit. Holes are now 25.8 mm (thread + 0.6 mm for JLCPCB's +-0.2 mm
    routing tolerance). An M25 nut is typically 30-32 mm AF / 35-37 mm AC,
    so the parts-free courtyard on both sides is now 38 mm; U3, C3, C5 and
    R13/R14 moved out of it (nearest part now 19.8 mm from a hole centre).
    Also fixes stitching-via placement: it only tested the via centre against
    rule areas, so vias just outside a keep-out polygon could still overlap it
    with their copper ring (4 DRC errors at the bigger USB ke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
    [tpms_panel-B_Cu.gbl, tpms_panel-B_Mask.gbs, tpms_panel-B_Paste.gbp, tpms_panel-B_Silkscreen.gbo, tpms_panel-Edge_Cuts.gm1, tpms_panel-F_Cu.gtl, tpms_panel-F_Mask.gts, tpms_panel-F_Paste.gtp]
